ama24/sortering-pnp/docs/images/eartip.png

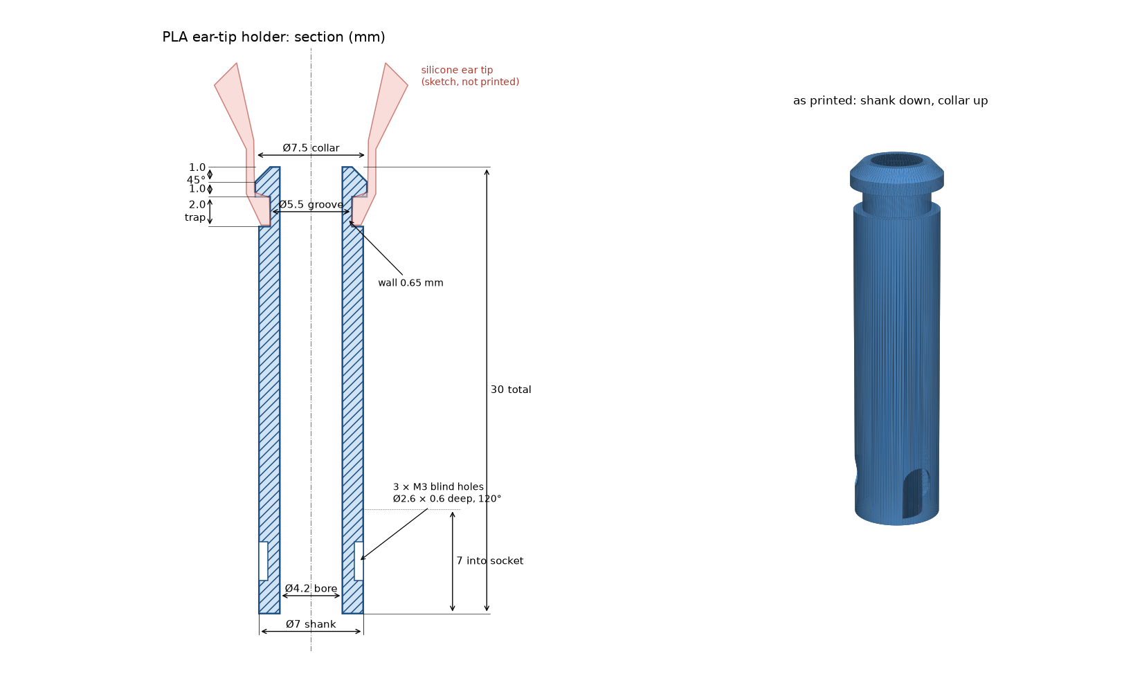
docs/images/eartip.png
