ama24/sortering-pnp/prints/cups/tip_eartip_pla.stl

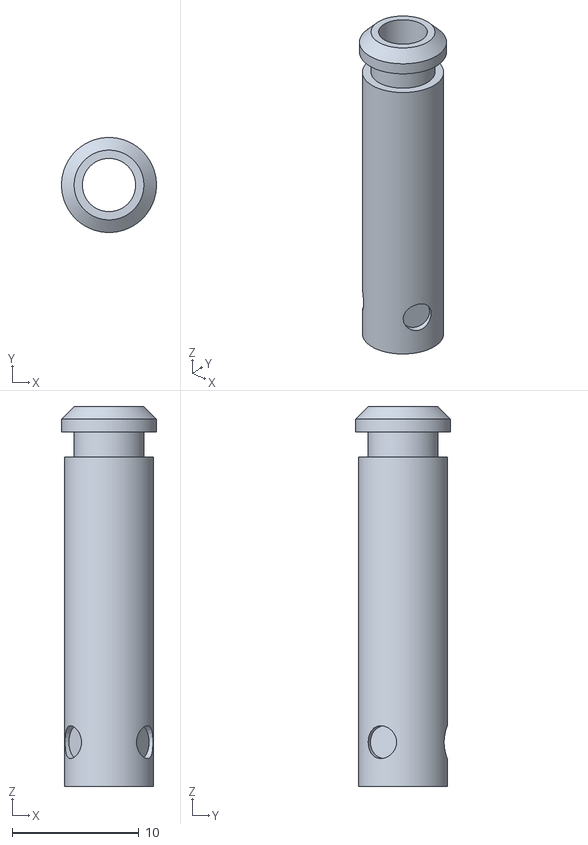
[picture p15: CAD file, 2026-11-09]
prints/cups/tip_eartip_pla.stl
7.50 x 7.50 x 30.0
