ama24/sortering-pnp/prints/mounts/camera_arm_ring.stl

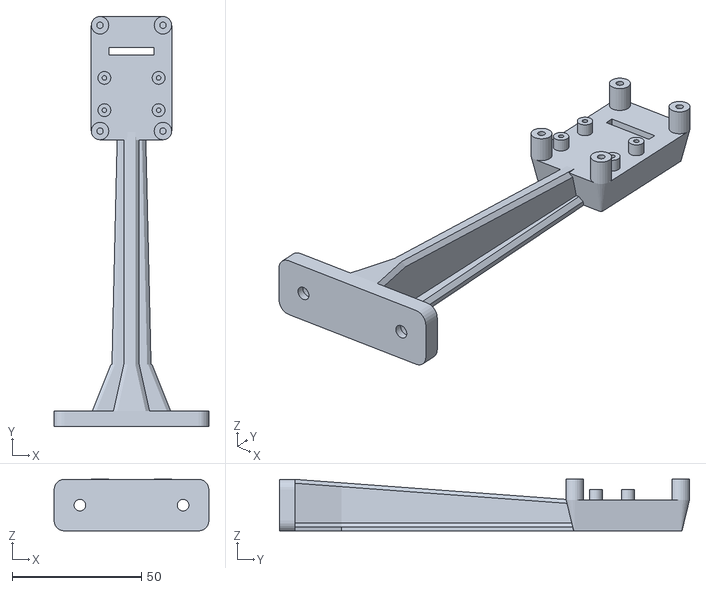
[picture p16: CAD file, 2026-11-07]
prints/mounts/camera_arm_ring.stl
60.0 x 158.9 x 20.1
