ama24/sortering-pnp/prints/tool/tool_holder.stl

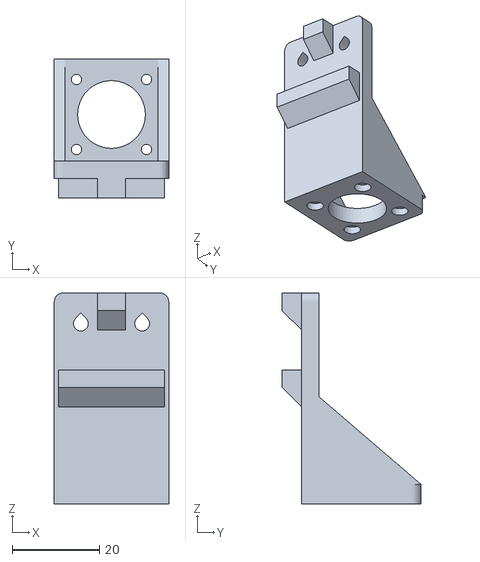
[picture p17: CAD file, 2026-11-08]
prints/tool/tool_holder.stl
26.2 x 31.8 x 48.2
