ama24/sortering-pnp/prints/cups/cup_AS.stl

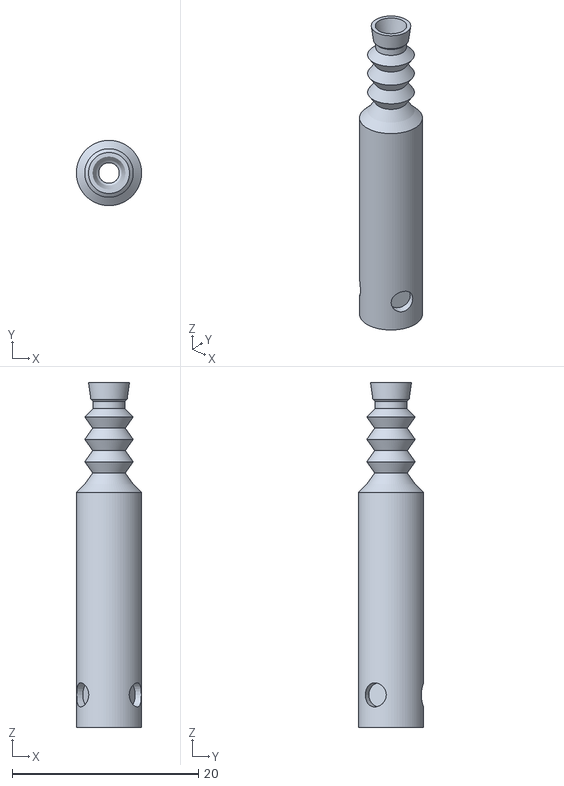
[picture p18: CAD file, 2026-11-08]
prints/cups/cup_AS.stl
7.00 x 7.00 x 37.0
