ama24/sortering-pnp/prints/mounts/ring_bracket.stl

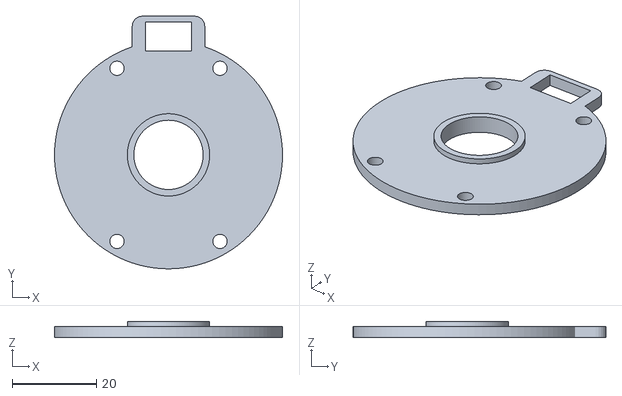
[picture p19: CAD file, 2026-11-07]
prints/mounts/ring_bracket.stl
54.0 x 59.8 x 3.80
