ama24/sortering-pnp/prints/cups/cup_AM_sieve.stl

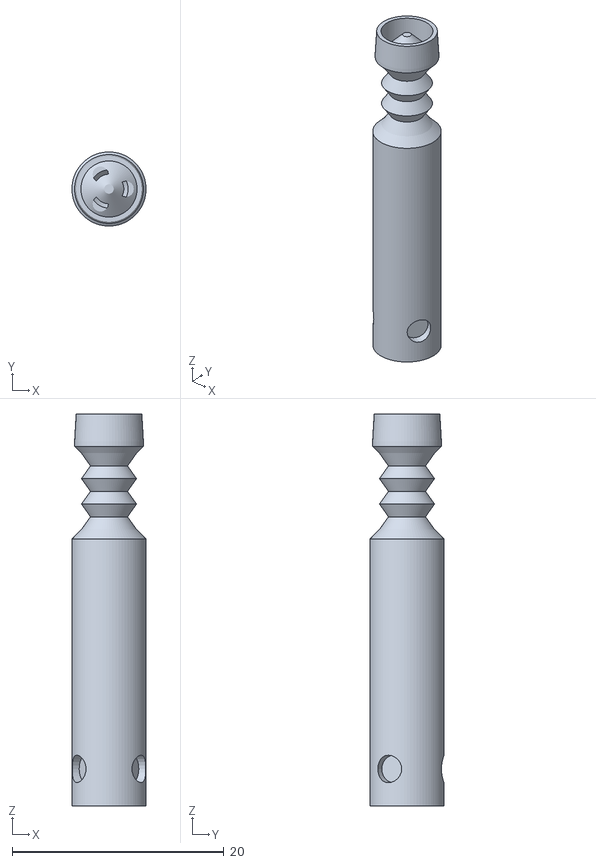
[picture p20: CAD file, 2026-11-08]
prints/cups/cup_AM_sieve.stl
7.00 x 7.00 x 37.0
