ama24/sortering-pnp/prints/mounts/camera_arm.stl

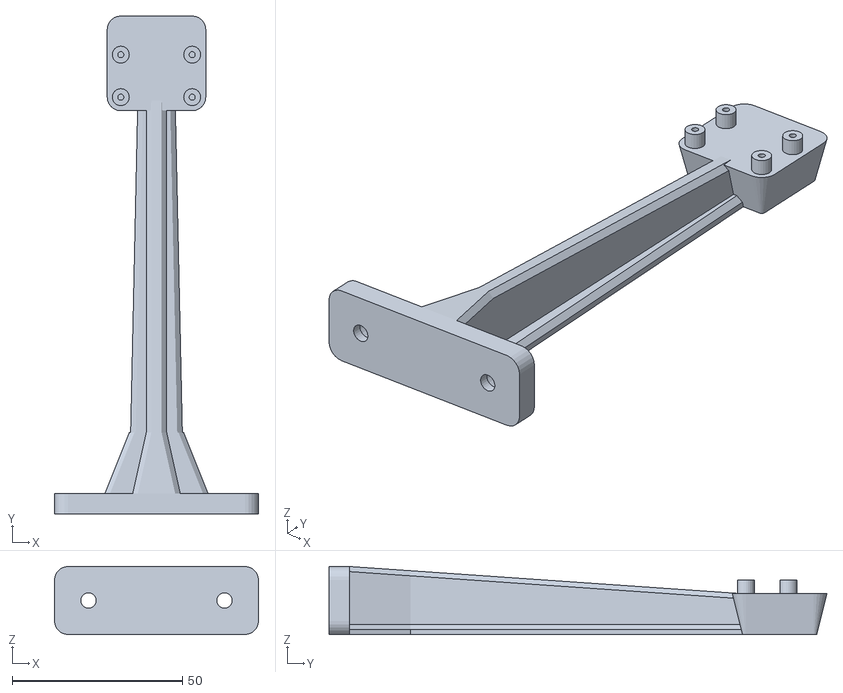
[picture p21: CAD file, 2026-11-07]
prints/mounts/camera_arm.stl
60.0 x 146.5 x 20.0
