ama24/sortering-pnp/prints/mounts/ring_diffuser.stl

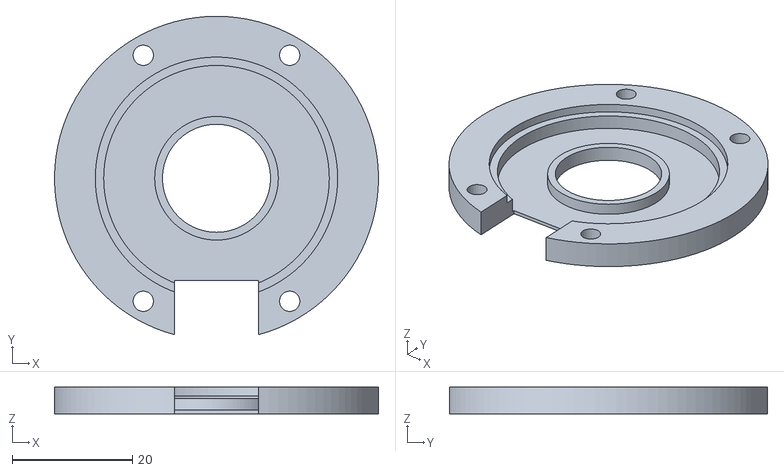
[picture p23: CAD file, 2026-11-07]
prints/mounts/ring_diffuser.stl
54.0 x 53.1 x 4.45
