ama24/sortering-pnp/prints/cups/cup_DM.stl

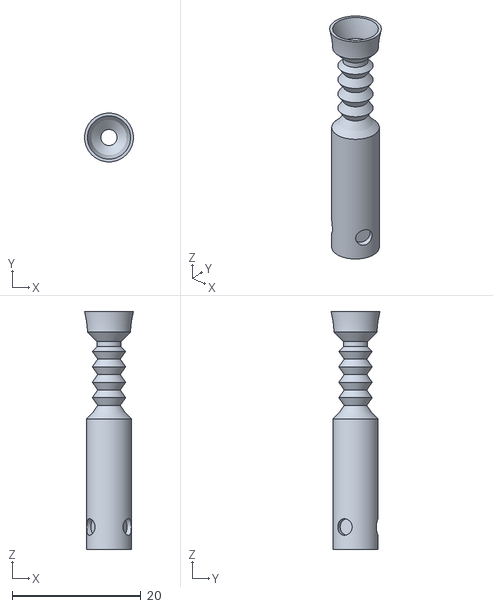
[picture p24: CAD file, 2026-11-08]
prints/cups/cup_DM.stl
7.60 x 7.60 x 37.0
