ama24/sortering-pnp/prints/mounts/ring_clamp.stl

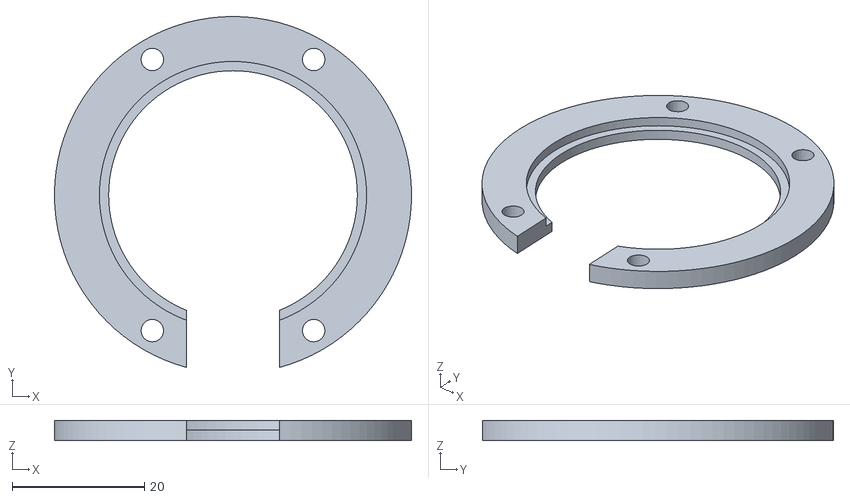
[picture p25: CAD file, 2026-11-07]
prints/mounts/ring_clamp.stl
54.0 x 53.1 x 3.05
