ama24/sortering-pnp/prints/cups/cup_DL_wide.stl

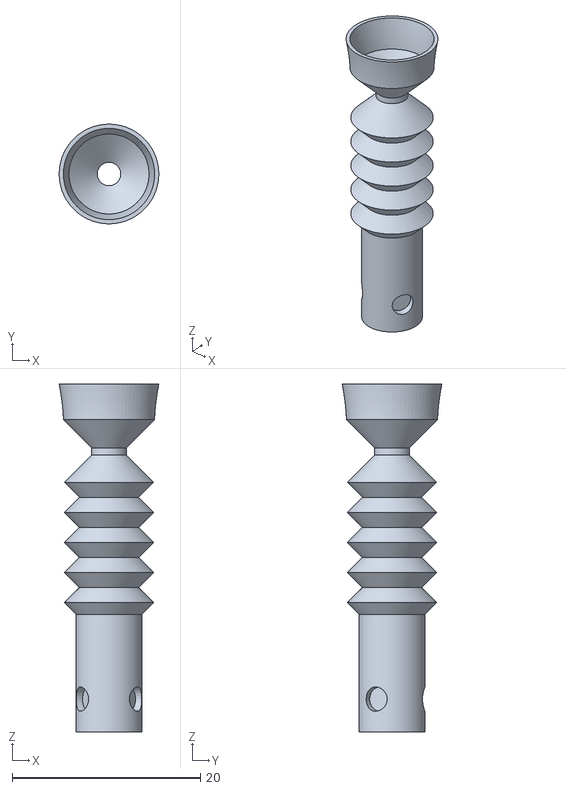
[picture p26: CAD file, 2026-11-08]
prints/cups/cup_DL_wide.stl
10.6 x 10.6 x 37.0
