ama24/sortering-pnp/prints/cups/cup_AM_sieve_wide.stl

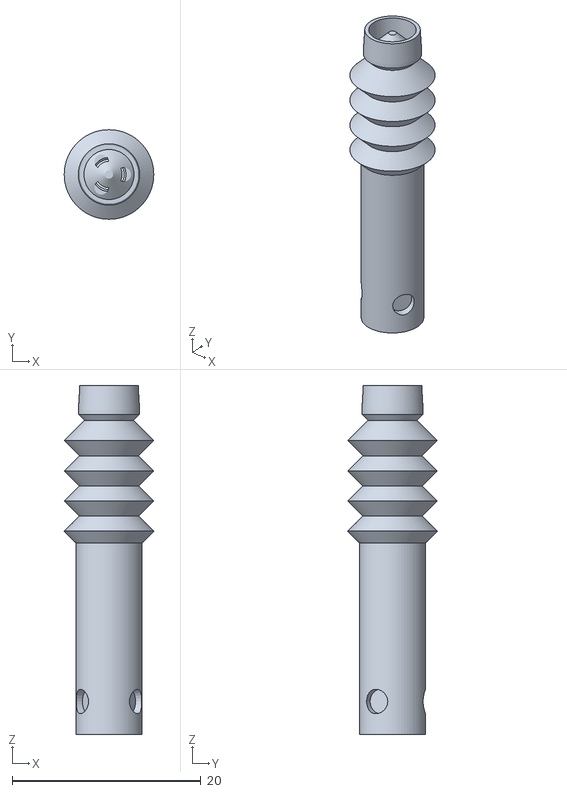
[picture p28: CAD file, 2026-11-08]
prints/cups/cup_AM_sieve_wide.stl
9.50 x 9.50 x 37.0
