ama24/sortering-pnp/prints/cups/cup_DM_sieve.stl

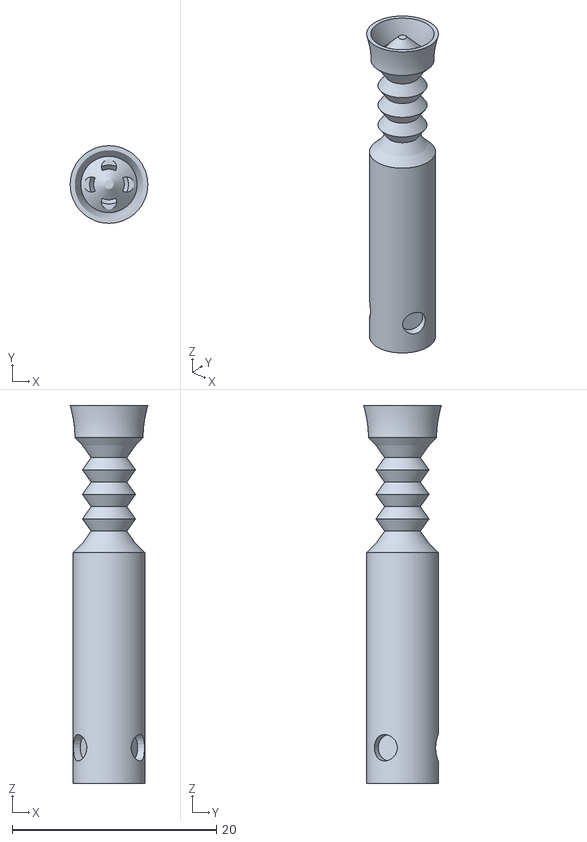
[picture p29: CAD file, 2026-11-08]
prints/cups/cup_DM_sieve.stl
7.60 x 7.60 x 37.0
