ama24/sortering-pnp/prints/cups/cup_AS_wide.stl

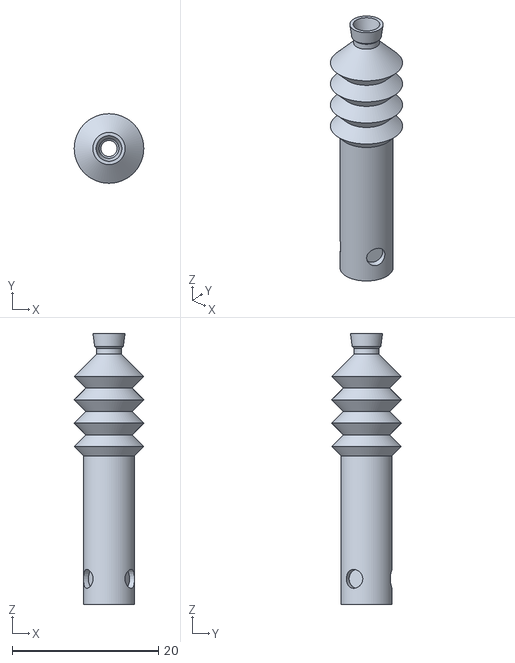
[picture p30: CAD file, 2026-11-08]
prints/cups/cup_AS_wide.stl
9.50 x 9.50 x 37.0
