ama24/sortering-pnp/prints/cups/cup_DL.stl

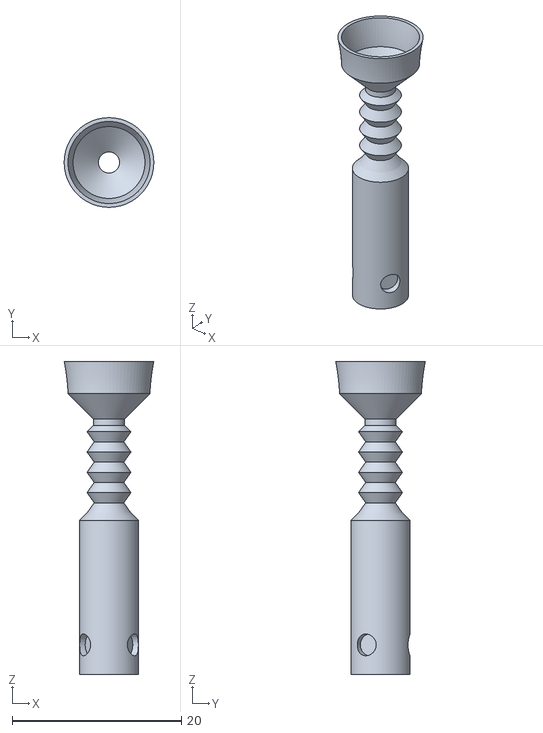
[picture p31: CAD file, 2026-11-08]
prints/cups/cup_DL.stl
10.6 x 10.6 x 37.0
