ama24/sortering-pnp/prints/cups/cup_DM_sieve_wide.stl

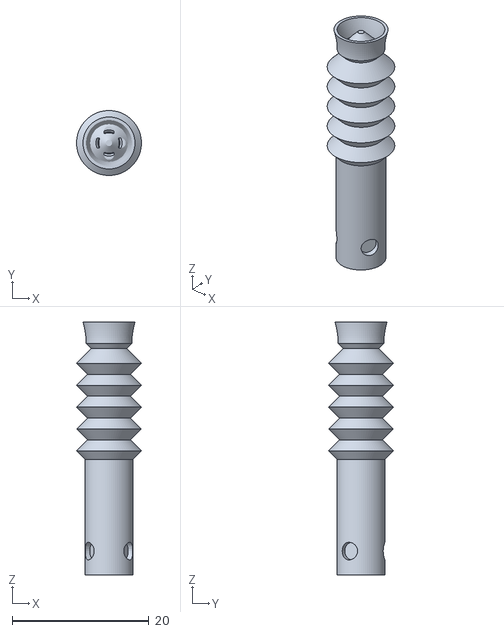
[picture p32: CAD file, 2026-11-08]
prints/cups/cup_DM_sieve_wide.stl
9.50 x 9.50 x 37.0
