ama24/sortering-pnp/(list of files, cad)

Other CAD files:
prints/cups/cup_DS.stl
prints/cups/cup_AM.stl
prints/cups/cup_DS_wide.stl
prints/cups/cup_DM_wide.stl
prints/cups/cup_AM_wide.stl
