ama24/sortering-pnp/src/sortering_pnp/pins.py

"""The picker, switched straight from the Raspberry Pi's pins by sortering-pnp (not by Klipper).

sortering-pnp runs on the Pi next to Klipper, so it needs no second Klipper board for the
picker. The action pin (GPIO12, header pin 32) switches a pump through a MOSFET module (on/off)
or drives the jaw / magnet servo; the turn pin (GPIO13, pin 33) drives the tweezers' turning
servo. Servos get hardware PWM from /sys/class/pwm (the pwm-2chan overlay, which install-pi.sh
adds to config.txt); a pump is a plain output through gpiozero (part of Raspberry Pi OS).

A pump can instead go on the printer board's heated-bed or hotend output (`picker.pump_switch`:
bed / hotend), in place of that heater, which is unplugged from it. Klipper owns those outputs,
so sortering-pnp asks it with G-code: SET_HEATER_TEMPERATURE to `pump_heater_target` (its PID
then switches the output fully on, the thermistor still reading the room) and back to 0.
Klipper's verify_heater stays on: it stops the printer if the output stays on longer than
`check_gain_time` without the heater warming (20 s for the hotend, 60 s for the bed by
default), so a part is never held that long; if the heater is still plugged in, it warms and
the pump is refused above `printer.max_hotend_c`.

Or on the board's part-cooling fan output (`pump_switch: fan`, Klipper's [fan]): M106 S255
switches it on, M107 off. No heater check is involved, so a part may be held as long as needed;
the pump must draw no more than the fan output gives (about 1 A on Creality boards).

Motion waits until Klipper has finished every move (M400) before it calls grab or release.
When the program stops, fails or ends, `off()` switches the pump off; a MOSFET module's
pull-down also keeps it off while nothing drives the pin.
"""

from __future__ import annotations

import logging
import time
from collections.abc import Callable
from pathlib import Path
from typing import Any, Protocol

from .config import Machine
from .printer.base import Printer, PrinterError

log = logging.getLogger("sortering_pnp.pins")

PWM_ROOT = Path("/sys/class/pwm")
SERVO_PERIOD_NS = 20_000_000  # 50 Hz
SERVO_MIN_NS, SERVO_MAX_NS = 500_000, 2_500_000  # 0 and 180 degrees
PWM_CHANNEL = {12: 0, 13: 1, 18: 0, 19: 1}  # GPIO -> PWM channel (pwm-2chan overlay)
TURN_S = 0.35  # a turn of the tweezers takes this long
PERMS_WAIT_S = 3.0  # udev hands a newly exported channel's files to the gpio group within this
HEATERS = {"bed": "heater_bed", "hotend": "extruder"}  # picker.pump_switch -> Klipper heater
HEATER_LAG_S = 0.4  # Klipper sets a heater's output at its next temperature reading (0.3 s)
HEATER_ON_LIMIT_S = {"heater_bed": 60.0, "extruder": 20.0}  # verify_heater's check_gain_time
FAN_LAG_S = 0.1  # M106 / M107 take effect at once (the moves are done: M400)


def _write(path: Path, value: str, sleep: Callable[[float], None] = time.sleep) -> None:
    """Write one sysfs file. Just after an export the channel's files exist but are still
    root's: udev (Raspberry Pi OS's 99-com.rules, and install-pi.sh's own rule) gives them to
    the gpio group a moment later, so a refusal is tried again for a few seconds."""
    step, waited = 0.05, 0.0
    while True:
        try:
            path.write_text(value)
            return
        except PermissionError:
            if waited >= PERMS_WAIT_S:
                raise PrinterError(
                    f"no permission to write {path}: run install-pi.sh again (it puts the user "
                    "in the gpio group and adds the udev rule that gives the gpio group the PWM "
                    "channels), then reboot once"
                ) from None
            sleep(step)
            waited += step


class Pins(Protocol):
    def grab(self) -> None: ...

    def release(self) -> None: ...

    def turn(self, angle_deg: float) -> None:
        """The turning servo to this angle (0..180, offset already added)."""

    def off(self) -> None:
        """Safe state: the pump off. Called on stop, errors and when the program ends."""

    def status(self) -> tuple[bool, str]:
        """Can the pins be used? (ok, what to do if not)"""

    def close(self) -> None: ...


class _Servo:
    """One hardware PWM channel in /sys/class/pwm/pwmchipN, as a hobby servo."""

    def __init__(
        self, chip: Path, channel: int, sleep: Callable[[float], None] = time.sleep
    ) -> None:
        self.dir = chip / f"pwm{channel}"
        self._sleep = sleep
        if not self.dir.is_dir():
            _write(chip / "export", str(channel), sleep)
            for _ in range(50):  # the channel's folder appears a moment later
                if (self.dir / "enable").exists():
                    break
                sleep(0.02)
        # its files are still root's for a moment more: _write waits for udev
        _write(self.dir / "period", str(SERVO_PERIOD_NS), sleep)
        self.enabled = False

    def angle(self, deg: float) -> None:
        a = min(max(float(deg), 0.0), 180.0)
        ns = SERVO_MIN_NS + (SERVO_MAX_NS - SERVO_MIN_NS) * a / 180.0
        _write(self.dir / "duty_cycle", str(int(ns)), self._sleep)
        if not self.enabled:
            _write(self.dir / "enable", "1", self._sleep)
            self.enabled = True


class HeaterPump:
    """A pump on the printer board's bed or hotend output, switched by Klipper (the heater is
    unplugged from that output). on() asks for `target` C; off() for 0, only after an on(): so
    stopping the program never touches a heater someone is printing with."""

    lag_s = HEATER_LAG_S

    def __init__(
        self,
        printer: Printer,
        switch: str,
        target: float,
        limit_c: float,
        clock: Callable[[], float] = time.monotonic,
    ) -> None:
        self.printer = printer
        self.switch = switch
        self.heater = HEATERS[switch]
        self.target = target
        self.limit_c = limit_c
        self._clock = clock
        self._since: float | None = None  # when it was switched on

    @property
    def is_on(self) -> bool:
        return self._since is not None

    def temperature(self) -> float | None:
        st = self.printer.status()
        if not st.ready:
            raise PrinterError(f"Klipper is not ready ({st.state}): it switches the pump")
        return st.bed_c if self.switch == "bed" else st.hotend_c

    def check(self) -> None:
        """Klipper has the heater, and it is cold: nothing but the pump is on its output."""
        t = self.temperature()
        if t is None:
            raise PrinterError(f"Klipper has no {self.heater}: choose another pump switch")
        if t > self.limit_c:
            raise PrinterError(
                f"the {self.switch} reads {t:.0f} C (limit {self.limit_c:.0f} C): unplug its "
                f"heater from the board's {self.switch} output, the pump goes there"
            )

    def on(self) -> None:
        self.check()
        self._send(self.target)
        self._since = self._clock()

    def off(self) -> None:
        if self._since is None:
            return
        held = self._clock() - self._since
        self._since = None
        self._send(0.0)
        limit = HEATER_ON_LIMIT_S[self.heater]
        if held > 0.75 * limit:
            log.warning(
                "the pump ran %.0f s on the %s output: Klipper stops the printer after about "
                "%.0f s",
                held,
                self.switch,
                limit,
            )

    def close(self) -> None:
        self.off()

    def _send(self, target: float) -> None:
        self.printer.gcode(f"SET_HEATER_TEMPERATURE HEATER={self.heater} TARGET={target:g}")


class FanPump:
    """A pump on the printer board's part-cooling fan output (Klipper's [fan]): M106 S255 on,
    M107 off, only after an on(), so stopping the program never stops a print's fan."""

    switch = "fan"
    lag_s = FAN_LAG_S

    def __init__(self, printer: Printer) -> None:
        self.printer = printer
        self._on = False

    @property
    def is_on(self) -> bool:
        return self._on

    def check(self) -> None:
        """Klipper is ready and has a part-cooling fan ([fan])."""
        st = self.printer.status()
        if not st.ready:
            raise PrinterError(f"Klipper is not ready ({st.state}): it switches the pump")
        if st.fan_speed is None:
            raise PrinterError("Klipper has no [fan]: choose another pump switch")

    def on(self) -> None:
        self.check()
        self.printer.gcode("M106 S255")
        self._on = True

    def off(self) -> None:
        if not self._on:
            return
        self._on = False
        self.printer.gcode("M107")

    def close(self) -> None:
        self.off()


def _gpiozero_output(pin: int) -> Any:
    from gpiozero import DigitalOutputDevice  # Raspberry Pi OS: python3-gpiozero

    return DigitalOutputDevice(pin, initial_value=False)


class PiPins:
    """The real pins. Opened on first use, so a PC (or a missing part) fails only there, with
    a message that says what to do."""

    def __init__(
        self,
        m: Machine,
        pwm_root: Path = PWM_ROOT,
        output: Callable[[int], Any] = _gpiozero_output,
        sleep: Callable[[float], None] = time.sleep,
        printer: Printer | None = None,  # switches a pump on the board's bed / hotend output
    ) -> None:
        self.m = m
        self.printer = printer
        self.pwm_root = pwm_root
        self._output = output
        self._sleep = sleep
        self._pump: Any = None
        self._servos: dict[int, _Servo] = {}
        self._mode: tuple[str, str] | None = None  # the picker type and pump switch opened

    # ------------------------------------------------------------------ opening
    def _chip(self) -> Path:
        n = self.m.picker.pwm_chip
        if n is not None:
            chip = self.pwm_root / f"pwmchip{n}"
            if chip.is_dir():
                return chip
            raise PrinterError(f"no {chip}: is picker.pwm_chip right?")
        chips = sorted(self.pwm_root.glob("pwmchip*")) if self.pwm_root.is_dir() else []
        if not chips:
            raise PrinterError(
                "no hardware PWM for the servos: run install-pi.sh (it adds the pwm-2chan line "
                "to config.txt), then reboot once"
            )
        return chips[0]

    def _servo(self, gpio: int) -> _Servo:
        if gpio not in self._servos:
            if gpio not in PWM_CHANNEL:
                raise PrinterError(f"GPIO{gpio} has no hardware PWM: servos go on GPIO12/13")
            self._servos[gpio] = _Servo(self._chip(), PWM_CHANNEL[gpio], self._sleep)
        return self._servos[gpio]

    def _open(self) -> None:
        pk = self.m.picker
        mode = (pk.mode, pk.pump_switch)
        if self._mode == mode:
            return
        self.close()  # another type was chosen: let go of the old pins
        t = pk.kind
        try:
            if t.pump and pk.pump_switch in HEATERS:
                if self.printer is None:
                    raise PrinterError("no printer to switch the pump through")
                self._pump = HeaterPump(
                    self.printer,
                    pk.pump_switch,
                    pk.pump_heater_target,
                    self.m.printer.max_hotend_c,
                )
            elif t.pump and pk.pump_switch == "fan":
                if self.printer is None:
                    raise PrinterError("no printer to switch the pump through")
                self._pump = FanPump(self.printer)
            elif t.pump:
                self._pump = self._output(pk.action_pin)
            else:
                self._servo(pk.action_pin)
            if t.rotates and not pk.rotate_macro:  # a stepper turns through Klipper instead
                self._servo(pk.turn_pin)
        except PrinterError:
            raise
        except ImportError as exc:
            raise PrinterError(
                "gpiozero is missing (sudo apt install python3-gpiozero, or run install-pi.sh)"
            ) from exc
        except Exception as exc:  # noqa: BLE001 - OSError, lgpio's "GPIO busy", gpiozero's own
            raise PrinterError(f"the Pi's pins cannot be used: {exc}") from exc
        self._mode = mode

    def status(self) -> tuple[bool, str]:
        try:
            self._open()
        except PrinterError as exc:
            return False, str(exc)
        pk = self.m.picker
        t = pk.kind
        if isinstance(self._pump, (HeaterPump, FanPump)):
            try:
                if not self._pump.is_on:  # letting go is never refused
                    self._pump.check()
            except PrinterError as exc:
                return False, str(exc)
            used = [f"the board's {pk.pump_switch} output (pump, through Klipper)"]
        else:
            used = [f"GPIO{pk.action_pin} ({'pump' if t.pump else 'servo'})"]
        if t.rotates:
            used.append(
                f"turning: {pk.rotate_macro} in Klipper"
                if pk.rotate_macro
                else f"GPIO{pk.turn_pin} (turning servo)"
            )
        return True, "ready: " + ", ".join(used)

    def _ready(self) -> None:
        ok, why = self.status()
        if not ok:
            raise PrinterError(why)

    # ------------------------------------------------------------------ actions
    def _set(self, holding: bool) -> None:
        self._ready()
        pk = self.m.picker
        t = pk.kind
        if t.pump:
            if holding:
                self._pump.on()
            else:
                self._pump.off()
            if isinstance(self._pump, (HeaterPump, FanPump)):
                self._sleep(self._pump.lag_s)
        else:
            angle = pk.grab_angle if holding else pk.release_angle
            if angle is None:
                angle = t.grab_angle if holding else t.release_angle
            self._servo(pk.action_pin).angle(float(angle or 0.0))
        self._sleep((t.grab_s if holding else t.release_s) + pk.dwell_s)

    def grab(self) -> None:
        self._set(True)

    def release(self) -> None:
        self._set(False)

    def turn(self, angle_deg: float) -> None:
        self._ready()
        self._servo(self.m.picker.turn_pin).angle(angle_deg % 180.0)
        self._sleep(TURN_S)

    def off(self) -> None:
        try:
            if self._pump is not None:
                self._pump.off()
        except Exception:  # noqa: BLE001 - the safe state must never raise
            log.exception("could not switch the pump off")

    def close(self) -> None:
        self.off()
        if self._pump is not None:
            try:
                self._pump.close()
            except Exception:  # noqa: BLE001
                log.exception("could not close the pump pin")
        self._pump = None
        self._servos = {}
        self._mode = None


def make_pins(m: Machine, printer: Printer) -> Pins:
    """The simulator's pins with the simulated printer, the Pi's pins otherwise."""
    from .printer.sim import SimPins, SimPrinter

    if isinstance(printer, SimPrinter):
        return SimPins(printer)
    return PiPins(m, printer=printer)
