ama24/sortering-pnp/src/sortering_pnp/runner.py

"""The sorting loop and everything the web page and the printer menu can ask for.

One cycle: photo position -> photo -> parts and markers -> did the last pick work? -> plan ->
pick and drop (or shake) -> again. Commands (start, pause, resume, stop, step) arrive from the web
page or from the printer's menu and are handled between moves, never in the middle of one: a
part in the picker is always dropped first.
"""

from __future__ import annotations

import copy
import dataclasses
import logging
import math
import threading
import time
from collections import Counter, deque
from collections.abc import Callable, Sequence
from concurrent.futures import Future, ThreadPoolExecutor
from dataclasses import dataclass, field
from pathlib import Path
from typing import Any

import numpy as np

from . import binscheck, binspec, pickers
from . import files as files_mod
from .analysis import ModelChoice
from .binswap import BinRequest, after_ok, choose_swap
from .camera import mirrored, orientation, rotated
from .config import HOME_CORNERS, PUMP_SWITCHES, RUN_MODES, SPEED_RANGE, Machine
from .fill import BinFill, CatalogueVolumes, Packing, bin_room_mm3, part_volume_mm3
from .grip import jaw_angle
from .headcam import merge_markers, merge_parts, shift_part, tiles
from .io import read_json, write_json
from .layout import Layout, yaw_from_up
from .leds import Lights, make_leds, parse_hex
from .models import ModelError, ModelStore
from .parts import Part, compute_gaps, to_bed
from .photos import Photos
from .printer import Motion, Printer, PrinterError
from .rules import family, wild_key
from .rules import match as rule_match
from .setup import KEYS as SETUP_KEYS
from .setup import Setup
from .startup import Checklist, kind_of, parts_in_bin
from .strategies import STRATEGIES, Plan, Planner
from .todo import TodoList
from .transform import MIN_SPREAD_MM, BedCalibration, Transform2D
from .trayview import (
    BinsView,
    WorkArea,
    bin_floor,
    bins_area,
    code_quads_px,
    paint_outside,
    parse_colour,
)
from .trayview import rect as tray_rect
from .vision import Shot, Vision

log = logging.getLogger("sortering_pnp.runner")


@dataclass
class State:
    status: str = "idle"  # idle | running | paused | stopping | done | stuck | error
    message: str = "ready"
    strategy: str = "sort"
    plan: str = ""
    picks: int = 0
    failed_picks: int = 0
    counts: dict[int, int] = field(default_factory=dict)
    shot: str | None = None  # file name of the latest picture with outlines
    timing: dict[str, float] = field(default_factory=dict)  # the last cycle: photo, pick, drop
    parts: list[dict[str, Any]] = field(default_factory=list)
    markers: list[dict[str, Any]] = field(default_factory=list)
    phase: str = ""  # what the machine does right now, in a few words
    target: dict[str, Any] | None = None  # the part it picks next (Device tab: boxed)
    view: str | None = None  # the latest photo without drawings (the page draws on it)
    view_h: list[list[float]] | None = None  # plate mm -> view pixels (3x3 homography)
    # the Device tab's "In the tray": what the last finished analysis found (cls, length,
    # in_work per part), kept while the next photo is taken; None until a model has looked
    census: list[dict[str, Any]] | None = None
    analysing: bool = False  # a new photo is shown, its parts are not known yet


ADJUST_RANGE = {  # Camera Calibration tab: what the sliders may set
    "lens_position": (0.0, 15.0),
    "red_gain": (0.5, 8.0),
    "blue_gain": (0.5, 8.0),
    "exposure_us": (100, 200000),
    "gain": (1.0, 16.0),
    "brightness": (-1.0, 1.0),
    "contrast": (0.0, 2.0),
    "sharpness": (0.0, 4.0),
    "saturation": (0.0, 2.0),
}


class Runner:
    def __init__(
        self, m: Machine, printer: Printer, vision: Vision, store: ModelStore | None = None
    ) -> None:
        self.m = m
        self.printer = printer
        self.motion = Motion(printer, m)
        self.pins = self.motion.pins  # the picker, switched by sortering-pnp itself (pins.py)
        self._leds_driver = make_leds(m, printer)  # the LEDs, on the Pi's SPI (leds.py)
        self.vision = vision
        self.store = store
        self.state = State(strategy=m.run.strategy)
        self.events: deque[str] = deque(maxlen=300)
        self.console: deque[str] = deque(maxlen=200)  # short lines: what it decides
        self._last_seen = ""
        self._lock = threading.RLock()  # the printer: one user at a time (loop or web page)
        self._thread: threading.Thread | None = None
        self._pause = threading.Event()
        self._stop = threading.Event()
        self._now = threading.Event()  # automatic mode: Resume / Start, look and sort now
        self._in_auto = False
        self._mode = ""  # what the sorter thread runs: auto, sort, step or task (Resync, ...)
        self._next_look: float | None = None  # automatic mode: when it looks again (time.time)
        self._shot_t: float | None = None  # when the photo on the page was taken
        self.startup = Checklist()  # the start-up check (startup.py), shown on the Device tab
        self._started_up = False  # done since the program started
        self._shot_no = 0
        self.calib_pairs: list[dict[str, Any]] = []
        cal = self.calibration()
        if cal is not None:
            self.calib_pairs = list(cal.pairs)
        self.last_shot: Shot | None = None
        self._claims_lock = threading.RLock()
        # wild bin marker -> what it collects; bin marker -> parts in it since it was emptied
        self.claims, self.bin_counts, self.bin_volume = self._load_claims()
        self.volumes = self._load_volumes()
        self.ready: dict[int, dict[str, Any]] = {}  # bins that can be taken out
        self.requests: list[BinRequest] = self._loaded_requests  # bin changes, until the OK
        # a bin change takes two OKs (web page or printer menu): the first parks the machine
        # (bed out, hands safe), the second says the bins are changed: a photo checks them
        self._layout_changed = threading.Event()  # the page saved the layout while sorting
        self._park = threading.Event()  # first OK, while sorting: park after this move
        self._ok = threading.Event()  # second OK: the bins are changed
        self.swap_phase = ""  # "" sorting | parked (waiting for the second OK)
        self._no_swap_said = ""
        self.mask_checked = False  # the tray view was checked and saved (Calibrate tab)
        self._crop: dict[str, Any] = {}  # Camera cropping being tried (margin, colour), not saved
        self._binsview: dict[str, Any] = {}  # Bins view being tried (margin, on), not saved
        self._layout_cache: tuple[tuple[str, int, int], Layout] | None = None
        self._tip_touch: tuple[float, float] | None = None  # (offset, surface_z) of the Tip step
        self.markers_seen: set[int] = set()  # every code the camera has read
        self._load_tool()
        self._load_machine()
        self.lights = Lights(m, self._leds_driver)
        self.lights.apply()  # lit from the start when always on
        setup_path = self.m.path(self.m.paths.setup)
        assert setup_path is not None
        self.setup = Setup(setup_path)
        todo_path = self.m.path(self.m.paths.todo)
        assert todo_path is not None
        self.todo = TodoList(todo_path)
        self.photos = Photos(self)  # calibration and real photos (Calibrate and Photos tabs)
        # the simulator needs no setup; a real printer does
        self.require_setup = self.m.printer.driver != "sim"
        self._setup_homed = False  # homed from the Setup tab since the program started
        self._setup_picker: set[str] = set()  # grab / release tried
        self._tool: str | None = None  # the tool Klipper said is mounted, when last asked
        self._calib_markers: list[dict[str, Any]] = []  # the codes in the last calibration photo
        self._calib_fit: dict[str, Any] | None = None  # the last Fit (Camera to printer)

    # ------------------------------------------------------------------ files
    @property
    def layout_path(self) -> Path:
        p = self.m.path(self.m.paths.layout)
        assert p is not None
        return p

    @property
    def transform_path(self) -> Path:
        p = self.m.path(self.m.paths.transform)
        assert p is not None
        return p

    @property
    def runs_dir(self) -> Path:
        p = self.m.path(self.m.paths.runs)
        assert p is not None
        return p

    def layout(self) -> Layout:
        """The layout file, parsed again only when it changed (the page asks for the state
        every second; parsing it each time costs the Pi's CPU and slows every answer). A copy:
        callers may change it."""
        p = self.layout_path
        try:
            st = p.stat()
            key = (str(p), st.st_mtime_ns, st.st_size)
        except FileNotFoundError:
            return Layout.load(p)
        cached = self._layout_cache
        if cached is None or cached[0] != key:
            cached = self._layout_cache = (key, Layout.load(p))
            self._follow_surface(cached[1])
        return copy.deepcopy(cached[1])

    def calibration(self) -> BedCalibration | None:
        return BedCalibration.load(self.transform_path)

    def transform(self) -> Transform2D:
        cal = self.calibration()
        if cal is not None:
            return cal.transform
        if self.m.printer.driver != "sim":
            if self.transform_path.is_file():  # saved, but unusable (e.g. one tip position)
                self.setup.reset("camera")
                raise PrinterError(
                    "Camera to printer is not usable (the tip was at the same place for every "
                    "code): do Setup step 6 again"
                )
            raise PrinterError("the camera is not calibrated to the printer yet: Setup step 6")
        return Transform2D.identity()

    # ------------------------------------------------------------------ status
    def note(self, text: str) -> None:
        log.info(text)
        self.events.append(time.strftime("%H:%M:%S ") + text)

    def say(self, text: str) -> None:
        """One short line on the page's console: what the machine sees and decides."""
        self.console.append(time.strftime("%H:%M:%S ") + text)

    def phase(self, text: str) -> None:
        """What the machine does right now (the Device tab's activity), and a console line."""
        self._set(phase=text)
        self.say(text)

    def _say_seen(self, parts: list[Any], layout: Layout) -> None:
        """What lies on the plate, grouped: '7 on the plate: 3 DIN912_M4x16 · 2 DIN934_M4'."""
        from collections import Counter

        on = [p for p in parts if layout.in_work(p.bed_xy, self.m.run.work_margin_mm)]
        kinds = Counter(
            p.cls + (f"x{p.length_mm:g}" if p.length_mm is not None else "") for p in on
        )
        line = (
            f"{len(on)} on the plate: "
            + " · ".join(f"{n} {k}" for k, n in kinds.most_common(6))
            + (" …" if len(kinds) > 6 else "")
            if on
            else "plate empty"
        )
        if line != self._last_seen:
            self.say(line)
            self._last_seen = line

    def _set(self, **kw: Any) -> None:
        for k, v in kw.items():
            setattr(self.state, k, v)

    def snapshot(self) -> dict[str, Any]:
        s = self.state
        return {
            "status": s.status,
            "message": s.message,
            "strategy": s.strategy,
            "plan": s.plan,
            "picks": s.picks,
            "failed_picks": s.failed_picks,
            "counts": {str(k): v for k, v in s.counts.items()},
            "shot": s.shot,
            "parts": s.parts,
            "census": s.census,
            "analysing": s.analysing,
            "markers": s.markers,
            "events": list(self.events)[-60:],
            "console": list(self.console)[-80:],
            "strategies": STRATEGIES,
            "calibrated": self.transform_path.is_file(),
            "calib_pairs": self.calib_pairs,
            "driver": self.m.printer.driver,
            **self.bins_state(),
            "requests": [r.to_dict() for r in self.requests],
            "mask_margin_mm": self.m.camera.mask_margin_mm,
            "swap_phase": self.swap_phase,
            **self.mode(),
            "tip_offset_z": self.m.tool.offset[2],
            "speed": self.speed_state(),
            "timing": self.state.timing,
            "phase": self.state.phase,
            "target": self.state.target,
            "view": self.state.view,
            "view_h": self.state.view_h,
            "next_look_s": (
                round(max(0.0, self._next_look - time.time()), 1)
                if self._next_look is not None
                else None
            ),
            "startup": self.startup.to_dict(),
            "shot_age_s": (
                round(time.time() - self._shot_t, 1) if self._shot_t is not None else None
            ),
            "setup": {
                "required": self.require_setup,
                "complete": not self.setup.missing(),
                "missing": self.setup.missing(),
            },
        }

    def mode(self) -> dict[str, Any]:
        """What really runs now, for the page (never what is only remembered): mode = auto
        (automatic mode, also while it waits), sort (Sort once), step (One pick), task (a
        Resync, check or bin change done for you) or "" (idle). auto_saved: automatic mode
        was on at the last stop and comes back at the next start."""
        alive = self._thread is not None and self._thread.is_alive()
        mode = ("auto" if self._in_auto else self._mode) if alive else ""
        return {"mode": mode, "auto": mode == "auto", "auto_saved": self.saved_mode()[0]}

    # ------------------------------------------------------------------ commands
    def command(self, cmd: str, strategy: str | None = None) -> str:
        cmd = (cmd or "").strip().lower()
        running = self._thread is not None and self._thread.is_alive()
        resuming = running and self.state.status in ("paused", "stuck") and cmd == "start"
        if (
            cmd in ("start", "step", "auto")
            and self.require_setup
            and self.setup.missing()
            and not resuming
        ):
            return "finish the Setup tab first: " + ", ".join(self.setup.missing())
        if cmd in ("start", "step"):
            if running:
                standby = self._in_auto and self.state.status in ("standby", "stuck", "error")
                if cmd == "start" and (self.state.status in ("paused", "stuck") or standby):
                    return self.command("resume")
                return "already running"
            strat = (strategy or self.state.strategy or self.m.run.strategy).lower()
            if strat not in STRATEGIES:
                return f"unknown strategy {strat!r}"
            self._pause.clear()
            self._stop.clear()
            self._set(
                strategy=strat,
                status="running",
                message=f"starting: {strat}",
                picks=0,
                failed_picks=0,
                counts={},
            )
            self._mode = cmd if cmd == "step" else "sort"
            self._thread = threading.Thread(
                target=self._run,
                args=(strat, 1 if cmd == "step" else None),
                name="sorter",
                daemon=True,
            )
            self._thread.start()
            return f"{cmd}: {strat}"
        if cmd == "auto":
            if running:
                return "already running: stop first"
            strat = (strategy or self.state.strategy or self.m.run.strategy).lower()
            if strat not in STRATEGIES:
                return f"unknown strategy {strat!r}"
            self._pause.clear()
            self._stop.clear()
            self._save_mode(True, strat)
            self._set(
                strategy=strat,
                status="standby",
                message="automatic mode",
                picks=0,
                failed_picks=0,
                counts={},
            )
            self._mode = "auto"
            self._thread = threading.Thread(
                target=self._auto, args=(strat,), name="sorter", daemon=True
            )
            self._thread.start()
            return f"automatic: {strat}"
        if cmd == "startup":
            if self.require_setup and self.setup.missing():
                return "finish the Setup tab first: " + ", ".join(self.setup.missing())
            return self._take_over("start-up check", self._startup_now)
        if cmd in ("change", "change_bin"):
            cmd = "ok"
        if cmd == "ok":  # Change bin: the first press parks; the second checks the bins
            if self.swap_phase == "parking":
                if running:
                    return "parking: wait until it stands still"
                self.swap_phase = ""  # stopped before it parked
            if self.swap_phase != "parked":
                if running:  # sorting or standing by: it parks after the move in progress
                    self.swap_phase = "parking"
                    self._park.set()
                    self._now.set()  # standby: at once
                    self._set(message="parking for a bin change")
                    return "parking"
                self.swap_phase = "parked"
                self._park_idle()
                self.note("parked for a bin change")
                return "parked: change the bins, then Done"
            if running:
                self._ok.set()
                self._now.set()
                self._set(message="checking the bins")
                return "checking the bins"
            self.swap_phase = ""
            res = self.bins_ok()
            return "; ".join(res["resolved"]) or "the bins were checked: nothing was asked for"
        if cmd == "pause":
            if running:
                self._pause.set()
                self._set(status="paused", message="pausing after this move")
            return "paused"
        if cmd == "resume":
            if running and self._in_auto and not self._pause.is_set():
                self._now.set()  # automatic mode waiting: look and sort now
                self._set(message="looking now: sorting what lies on the plate")
                return "looking now"
            if running:
                self._pause.clear()
                self._set(status="running", message="resumed")
            return "resumed"
        if cmd == "stop":
            self._save_mode(False)
            if running:
                self._stop.set()
                self._pause.clear()
                self._set(status="stopping", message="stopping after this move")
            return "stopping"
        if cmd in ("estop", "emergency_stop"):
            self._stop.set()
            self._pause.clear()
            self._save_mode(False)
            self.pins.off()
            try:
                self.printer.emergency_stop()
            finally:
                self._set(
                    status="error", message="EMERGENCY STOP: restart Klipper (FIRMWARE_RESTART)"
                )
                self.note("emergency stop")
            return "emergency stop sent"
        return f"unknown command {cmd!r}"

    def wait(self, timeout: float | None = None) -> None:
        """Until the sorter thread ends (a take-over's thread too)."""
        end = None if timeout is None else time.monotonic() + timeout
        while self._thread is not None:
            t = self._thread
            t.join(None if end is None else max(0.0, end - time.monotonic()))
            if t is self._thread or (end is not None and time.monotonic() >= end):
                return

    def _take_over(self, label: str, fn: Callable[[], str | None]) -> str:
        """Run `fn` now in the sorter thread: whatever runs (a run, automatic mode, a check)
        stops first, after the move in progress (a part in the picker is dropped first, the
        picker is off). Automatic mode carries on afterwards if it was on."""
        old = self._thread if self._thread is not None and self._thread.is_alive() else None
        resume = old is not None and (self._in_auto or self.saved_mode()[0])
        strategy = self.state.strategy
        if old is not None:
            self._stop.set()
            self._pause.clear()
            self._set(status="stopping", message=f"{label}: stopping the current move")
        else:
            self._set(status="running", message=label)

        def run() -> None:
            if old is not None:
                old.join()
            if self.swap_phase == "parking":  # stopped before it parked
                self.swap_phase = ""
            self._stop.clear()
            self._pause.clear()
            self._set(status="running", message=label)
            try:
                done = fn()
            except Exception as exc:  # noqa: BLE001 - shown on the page
                self.pins.off()
                log.exception(label)
                self.note(f"{label} failed: {exc}")
                self._set(status="error", message=f"{label} failed: {exc}")
                return
            if resume and not self._stop.is_set():
                self._auto(strategy)
            else:
                self._set(status="idle", message=done or f"{label}: done")

        self._mode = "task"
        self._thread = threading.Thread(target=run, name="sorter", daemon=True)
        self._thread.start()
        return f"{label}: stopping the current move first" if old is not None else label

    def _park_idle(self) -> None:
        """Change bin while idle: the bed out to the photo position, if it can move."""
        try:
            with self._lock:
                self.motion.preflight(home=False)
                self.motion.photo_position()
                self.motion.message("Swap bins, Change bin")
        except Exception as exc:  # noqa: BLE001 - not homed or no printer: the bins can still be changed
            log.info("not parked for the bin change: %s", exc)

    # ------------------------------------------------------------------ one photo
    def _photo_name(self) -> str:
        self._shot_no += 1
        return time.strftime("%Y%m%d-%H%M%S") + f"_{self._shot_no:04d}"

    def take_shot(
        self,
        layout: Layout,
        T: Transform2D | None,
        move: bool = True,
        area: str = "work",
        paint: bool | str = True,
    ) -> Shot:
        """Photo position, photo, parts (with printer X/Y when T is known), markers. `move`
        False: photograph where the bed is (standby with the motors off: still parked).
        A head camera photographs `area`: work (the tray), bins (the grid and around it) or
        here (one photo at the photo position: calibration). `paint`: True, the model sees only
        the tray's inside; "bins", only the floors of the bins whose codes are in the photo
        (camera.bins_mask, trayview.py); False, the whole photo."""
        work: WorkArea | BinsView | None
        if paint == "bins":
            c = self.m.camera
            work = BinsView(c.bins_margin_mm) if c.bins_mask and c.source != "head" else None
        else:
            work = self._work_area(layout, T) if paint else None
        if self.m.camera.source == "head":
            return self._head_shot(layout, T, area, work if isinstance(work, WorkArea) else None)
        with self._lock:
            if move:
                self.phase("parking at the photo position")
                self.motion.photo_position()
            name = self._photo_name()
            heights = lambda mid: _marker_plate_height(layout, mid)  # noqa: E731
            if hasattr(self.vision, "snap") and hasattr(self.vision, "analyse"):
                self.phase("taking a photo")
                with self.lights.for_photo():
                    photo = self.vision.snap(name)
                self._show_photo(photo, name)
                self.phase("running the model")
                try:
                    shot = (
                        self.vision.analyse(photo, name, heights, work)
                        if work is not None
                        else self.vision.analyse(photo, name, heights)
                    )
                finally:
                    self._set(analysing=False)
            else:
                self.phase("taking a photo")
                with self.lights.for_photo():
                    shot = (
                        self.vision.capture(name, heights, work)
                        if work is not None
                        else self.vision.capture(name, heights)
                    )
        return self._finish_shot(shot, layout, T)

    def _work_area(self, layout: Layout, T: Transform2D | None) -> WorkArea | None:
        """The tray's inside (and its corner post) in the plate frame, for painting the rest."""
        if T is None or not self.m.camera.mask:
            return None
        Ti = T.inverse()
        g = self.m.camera.mask_margin_mm  # + keeps more of the wall, - paints more of the floor
        x0, y0, x1, y1 = layout.work_rect()
        post = layout.work_keepout()
        holes = []
        if post is not None:
            px0, py0, px1, py1 = post
            holes = [Ti.apply(tray_rect(px0 + g, py0 + g, px1 - g, py1 - g))]
        return WorkArea(Ti.apply(tray_rect(x0 - g, y0 - g, x1 + g, y1 + g)), holes)

    # ------------------------------------------------------------------ what the model sees
    def mask_preview(self, margin_mm: float) -> dict[str, Any]:
        """A photo painted with this margin (not saved): the Device tab's photo shows what the
        model sees."""
        self._idle()
        layout, T = self.layout(), self.transform()
        with self._lock:
            self.motion.preflight(home=False)
        old = self.m.camera.mask_margin_mm
        self.m.camera.mask_margin_mm = float(margin_mm)
        try:
            shot = self.take_shot(layout, T)
        finally:
            self.m.camera.mask_margin_mm = old
        return {
            "image": shot.vis.name if shot.vis else None,
            "parts": len(shot.parts),
            "margin_mm": float(margin_mm),
        }

    def remember_machine(self, values: dict[str, Any]) -> None:
        """Keep values set in the page in machine.json (over machine.yaml)."""
        p = self.m.path(self.m.paths.machine)
        assert p is not None
        kept = read_json(p) if p.is_file() else {}
        write_json(p, {**kept, **values})

    def camera_height(self, height_mm: float) -> dict[str, Any]:
        """Skip the camera calibration for now (Calibrate tab): the camera is taken as straight
        down over the picture's centre, this high above the tray floor. A calibration made
        later replaces it."""
        self._idle()
        h = float(height_mm)
        if not 100.0 <= h <= 1000.0:
            raise ValueError("the camera's height: lens to the tray floor, 100 to 1000 mm")
        self.m.camera.height_mm = h
        self.remember_machine({"camera_height_mm": h})
        reload = getattr(self.vision, "reload_setup", None)
        if reload is not None:
            reload()
        self.note(f"camera calibration skipped: straight down, {h:g} mm above the tray floor")
        return self.photos.state()

    def camera_flip(self, hflip: bool, vflip: bool, turn90: bool | None = None) -> dict[str, Any]:
        """The picture's orientation (the camera's flips, both = turned 180 degrees, and a
        quarter turn in software), for photos and the live picture. What was fitted to the old
        picture no longer holds: Camera to printer (and a camera calibration) must be done
        again."""
        self._idle()
        c = self.m.camera
        q = c.turn90 if turn90 is None else bool(turn90)
        if (c.hflip, c.vflip, c.turn90) == (bool(hflip), bool(vflip), q):
            return self.photos.state()
        turned = c.turn90 != q
        c.hflip, c.vflip, c.turn90 = bool(hflip), bool(vflip), q
        self.remember_machine(
            {"camera_hflip": c.hflip, "camera_vflip": c.vflip, "camera_turn90": c.turn90}
        )
        reopen = getattr(self.vision, "reopen_camera", None)
        if reopen is not None:
            reopen()
        reload = getattr(self.vision, "reload_setup", None)
        if reload is not None and turned:  # the nominal camera's picture: taller, or wide again
            reload()
        self.calib_clear()
        self.setup.reset("camera")
        self.last_shot = None
        o = orientation(c.hflip, c.vflip, c.turn90)
        self.note(
            f"camera picture turned {o['turn']}°{', mirrored' if o['mirror'] else ''}: "
            "do Camera to printer again"
        )
        return self.photos.state()

    def camera_orient(self, action: str) -> dict[str, Any]:
        """Rotate 90° (clockwise) or Mirror (left-right), from the Camera Calibration tab."""
        c = self.m.camera
        step = {"rotate": rotated, "mirror": mirrored}.get(action)
        if step is None:
            raise ValueError("rotate or mirror")
        return self.camera_flip(*step(c.hflip, c.vflip, c.turn90))

    def camera_adjust(self, values: dict[str, Any]) -> dict[str, Any]:
        """Focus, white balance, exposure and image adjustments from the page: kept, and
        applied to the camera at once (photos and the live picture)."""
        a = self.m.camera.adjust
        new = {k: v for k, v in (values or {}).items() if hasattr(a, k)}
        if values and not new:
            raise ValueError("nothing to adjust")
        for k, v in new.items():
            old = getattr(a, k)
            if isinstance(old, str):
                if v not in ("auto", "manual"):
                    raise ValueError(f"{k}: auto or manual")
                setattr(a, k, v)
            else:
                lo, hi = ADJUST_RANGE[k]
                setattr(a, k, type(old)(min(hi, max(lo, float(v)))))
        self.remember_machine({"camera_adjust": dataclasses.asdict(a)})
        apply = getattr(self.vision, "adjust_camera", None)
        now = apply() if apply is not None else {}
        return {"adjust": dataclasses.asdict(a), "now": now}

    def camera_focus(self) -> dict[str, Any]:
        """Autofocus once on the tray, then keep that lens position (focus: manual)."""
        focus = getattr(self.vision, "focus_once", None)
        pos = focus() if focus is not None else None
        if pos is None:
            raise ValueError("no autofocus on this camera")
        out = self.camera_adjust({"focus": "manual", "lens_position": pos})
        self.note(f"camera focused: lens position {pos:.2f} (about {1000 / max(pos, 0.01):.0f} mm)")
        return out

    def camera_state(self) -> dict[str, Any]:
        c = self.m.camera
        now = getattr(self.vision, "camera_now", lambda: {})()
        return {
            "adjust": dataclasses.asdict(c.adjust),
            "now": now,
            "orientation": orientation(c.hflip, c.vflip, c.turn90),
            "locked": bool(c.settings),
        }

    def calibration_settings(
        self, measured_square_mm: float | None, board_thickness_mm: float
    ) -> dict[str, Any]:
        c = self.m.calibration
        c.measured_square_mm = float(measured_square_mm) if measured_square_mm else None
        c.board_thickness_mm = float(board_thickness_mm)
        self.remember_machine(
            {
                "calibration": {
                    "measured_square_mm": c.measured_square_mm,
                    "board_thickness_mm": c.board_thickness_mm,
                }
            }
        )
        return self.photos.state()

    def calibration_replaced(self) -> None:
        """A new camera calibration: its plate frame starts at the board, so the old camera-to-
        printer fit is wrong now. It is kept aside, and the Setup step asks for it again."""
        if self.transform_path.is_file():
            aside = self.transform_path.with_name(
                self.transform_path.stem + time.strftime("_before_%Y%m%d-%H%M%S.json")
            )
            self.transform_path.replace(aside)
        self.calib_pairs = []
        self.setup.reset("camera")
        self.note("new camera calibration: redo Camera to printer (Setup tab, step 6)")

    def mask_save(self, margin_mm: float) -> dict[str, Any]:
        self.remember_machine({"mask_margin_mm": float(margin_mm)})
        self.m.camera.mask_margin_mm = float(margin_mm)
        self.mask_checked = True
        self.note(f"tray view saved: margin {float(margin_mm):g} mm")
        return {"margin_mm": float(margin_mm), "saved": True}

    # ------------------------------------------------------------------ camera cropping
    def crop_state(self) -> dict[str, Any]:
        """Camera cropping (Calibrate tab): only for the model that finds the parts. It needs the
        camera-to-printer fit and the bins (where the tray is); the camera calibration, or the
        straight-down camera at its height until then."""
        missing = []
        if self.calibration() is None and self.m.printer.driver != "sim":
            missing.append("Camera to printer (Setup tab, step 6)")
        if not self.setup.is_done("layout") and self.m.printer.driver != "sim":
            missing.append("the bins found (Setup tab, step 7)")
        c = self.m.camera
        return {
            "ready": not missing,
            "missing": missing,
            "margin_mm": float(self._crop.get("margin", c.mask_margin_mm)),
            "colour": str(self._crop.get("colour", c.mask_colour)),
            "saved_margin_mm": c.mask_margin_mm,
            "saved_colour": c.mask_colour,
            "changed": bool(self._crop),
        }

    def crop_preview(self, margin_mm: float, colour: str) -> dict[str, Any]:
        """Try a margin and a colour on the live picture (not saved)."""
        parse_colour(colour)  # auto or #RRGGBB, else ValueError
        self._crop = {"margin": float(margin_mm), "colour": colour}
        return self.crop_state()

    def crop_save(self, margin_mm: float, colour: str) -> dict[str, Any]:
        parse_colour(colour)
        self.mask_save(margin_mm)
        self.remember_machine({"mask_colour": colour})
        self.m.camera.mask_colour = colour
        self._crop = {}
        return self.crop_state()

    def crop_frame(self, frame: np.ndarray) -> np.ndarray:
        """A live frame painted and cut as the model will see it: the tray's inside only (the
        working area of the layout, through the camera-to-printer fit), with the margin and
        colour being tried."""
        from .photos import placeholder

        st = self.crop_state()
        cam = getattr(self.vision, "cam_full", None)
        calib = getattr(self.vision, "calibration", None)
        if not st["ready"] or cam is None:
            return placeholder("Camera cropping needs: " + ", ".join(st["missing"] or ["a camera"]))
        c = self.m.camera
        old = (c.mask, c.mask_margin_mm)
        c.mask, c.mask_margin_mm = True, st["margin_mm"]
        try:
            work = self._work_area(self.layout(), self.transform())
        finally:
            c.mask, c.mask_margin_mm = old
        if work is None:
            return placeholder("no working area: Setup tab, step 7 (Find bins)")
        s = frame.shape[1] / float(cam.image_size[0])

        def px(poly: np.ndarray) -> np.ndarray:
            return cam.project(np.c_[poly, np.zeros(len(poly))]) * s

        img = paint_outside(
            frame, px(work.outline), [px(h) for h in work.holes], parse_colour(st["colour"])
        )
        roi = (calib or {}).get("roi")
        if roi:  # the model gets this part of the photo (its size unchanged)
            x0, y0 = int(roi["x0"] * s), int(roi["y0"] * s)
            img = img[y0 : y0 + int(roi["h"] * s), x0 : x0 + int(roi["w"] * s)]
        return img

    # ------------------------------------------------------------------ speed and mode
    def speed_state(self) -> dict[str, Any]:
        """The Device tab's Speed and Mode buttons: what is set now (used from the next move,
        and for the mode from the next photo)."""
        r = self.m.run
        return {
            "pct": r.speed_pct,
            "range": list(SPEED_RANGE),
            "mode": r.mode,
            "turbo_picks": r.turbo_picks,
        }

    def set_speed(self, pct: float) -> dict[str, Any]:
        """Speed of every move, 50..300 % (feed rates and accelerations; Klipper's limits still
        apply). Used from the next move, also while sorting; kept in machine.json."""
        pct = float(pct)
        lo, hi = SPEED_RANGE
        if not lo <= pct <= hi:
            raise ValueError(f"speed: {lo:g} to {hi:g} %")
        self.m.run.speed_pct = round(pct)
        self.remember_machine({"speed_pct": self.m.run.speed_pct})
        self.note(f"speed {self.m.run.speed_pct:g} %")
        return self.speed_state()

    def set_mode(self, mode: str, turbo_picks: int | None = None) -> dict[str, Any]:
        """Single (a photo before every pick) or turbo (`turbo_picks` picks per photo, the photo
        analysed while it goes on picking). Used from the next photo, also while sorting."""
        if mode not in RUN_MODES:
            raise ValueError(f"mode: one of {', '.join(RUN_MODES)}")
        r = self.m.run
        if turbo_picks is not None:
            n = int(turbo_picks)
            if not 1 <= n <= 100:
                raise ValueError("turbo: 1 to 100 picks per photo")
            r.turbo_picks = n
        r.mode = mode
        self.remember_machine({"run_mode": r.mode, "turbo_picks": r.turbo_picks})
        self.note("mode: single" if mode == "single" else f"mode: turbo, {r.turbo_picks} per photo")
        return self.speed_state()

    # ------------------------------------------------------------------ bins view
    def binsview_state(self) -> dict[str, Any]:
        """Bins view (Calibrate tab): what the model sees when it looks into the bins: the
        floors of the bins whose codes are in the picture (trayview.py). Needs the camera
        calibration (or the straight-down camera) and the codes in view; nothing else."""
        c = self.m.camera
        return {
            "enabled": bool(self._binsview.get("enabled", c.bins_mask)),
            "margin_mm": float(self._binsview.get("margin", c.bins_margin_mm)),
            "saved_enabled": c.bins_mask,
            "saved_margin_mm": c.bins_margin_mm,
            "changed": bool(self._binsview),
            "head": c.source == "head",  # the head camera looks at the bins unpainted
        }

    def binsview_preview(self, margin_mm: float, enabled: bool | None = None) -> dict[str, Any]:
        """Try a margin on the live picture (not saved)."""
        self._binsview["margin"] = float(margin_mm)
        if enabled is not None:
            self._binsview["enabled"] = bool(enabled)
        return self.binsview_state()

    def binsview_save(self, margin_mm: float, enabled: bool) -> dict[str, Any]:
        c = self.m.camera
        c.bins_margin_mm, c.bins_mask = float(margin_mm), bool(enabled)
        self.remember_machine({"bins_margin_mm": c.bins_margin_mm, "bins_mask": c.bins_mask})
        self._binsview = {}
        self.note(
            f"bins view saved: margin {c.bins_margin_mm:g} mm"
            if c.bins_mask
            else "bins view off: the model looks at the whole photo"
        )
        return self.binsview_state()

    def _bins_painted(
        self, frame: np.ndarray
    ) -> tuple[np.ndarray, list[tuple[int, np.ndarray]]] | str:
        """A live frame painted as the bins view (the margin being tried), cut to the
        calibration's ROI, and each bin's floor in its pixels; or why it cannot be."""
        from .markers import detect, marker_pose

        st = self.binsview_state()
        cam = getattr(self.vision, "cam_full", None)
        if cam is None:
            return "Bins view needs the camera"
        if not st["enabled"]:
            return "Bins view is off: the model looks at the whole photo"
        s = frame.shape[1] / float(cam.image_size[0])
        layout = self.layout()
        found = detect(frame)
        poses = [
            marker_pose(
                m,
                lambda px, mid=m.marker: cam.pixel_to_plate(
                    px / s, _marker_plate_height(layout, mid)
                ),
            )
            for m in found
        ]
        area = bins_area(poses, st["margin_mm"])
        if area is None:
            return "no bin codes in the picture"

        def px(poly: np.ndarray) -> np.ndarray:
            return cam.project(np.c_[poly, np.zeros(len(poly))]) * s

        img = paint_outside(
            frame,
            [px(o) for o in area.outlines],
            [px(h) for h in area.holes] + code_quads_px(m.corners_px for m in found),
            parse_colour(self.m.camera.mask_colour),
        )
        floors = []
        for m in poses:
            got = bin_floor(m.marker, m.centre, m.up_deg, st["margin_mm"])
            if got is not None:
                floors.append((m.marker, px(got[0])))
        calib = getattr(self.vision, "calibration", None)
        roi = (calib or {}).get("roi")
        if roi:  # the model gets this part of the photo (its size unchanged)
            x0, y0 = int(roi["x0"] * s), int(roi["y0"] * s)
            img = img[y0 : y0 + int(roi["h"] * s), x0 : x0 + int(roi["w"] * s)]
            floors = [(mk, f - (x0, y0)) for mk, f in floors]
        return img, floors

    def bins_frame(self, frame: np.ndarray) -> np.ndarray:
        """The live picture as the model sees the bins (Calibrate tab: Bins view)."""
        from .photos import placeholder

        got = self._bins_painted(frame)
        return placeholder(got) if isinstance(got, str) else got[0]

    def bins_snippets(self) -> bytes:
        """One JPEG: each bin's floor cut out of the bins view, side by side at the photo's own
        scale, with its code and size: does the model see every bin, and all of its floor?"""
        import cv2

        from .binspec import size_for_marker
        from .photos import placeholder

        frame = getattr(self.vision, "frame", lambda: None)()
        got = "no camera picture yet" if frame is None else self._bins_painted(np.asarray(frame))
        if isinstance(got, str):
            img = placeholder(got, (960, 200))
        else:
            view, floors = got
            tiles = []
            for mk, f in sorted(floors, key=lambda t: t[0]):
                x0, y0 = np.floor(f.min(axis=0)).astype(int)
                x1, y1 = np.ceil(f.max(axis=0)).astype(int)
                x0, y0 = max(x0 - 4, 0), max(y0 - 4, 0)
                x1, y1 = min(x1 + 4, view.shape[1]), min(y1 + 4, view.shape[0])
                if x1 - x0 < 8 or y1 - y0 < 8:
                    continue
                cut = view[y0:y1, x0:x1]
                size = size_for_marker(mk)
                head = np.full((26, max(cut.shape[1], 150), 3), 40, np.uint8)
                text = f"{mk}  {size.name if size else '?'}"
                cv2.putText(head, text, (6, 18), cv2.FONT_HERSHEY_SIMPLEX, 0.55, (255,) * 3, 1)
                body = np.full((cut.shape[0], head.shape[1], 3), 255, np.uint8)
                body[:, : cut.shape[1]] = cut
                tiles.append(np.vstack([head, body]))
            img = _tile(tiles) if tiles else placeholder("no bin floors in view", (960, 200))
        ok, buf = cv2.imencode(".jpg", img, [cv2.IMWRITE_JPEG_QUALITY, 85])
        if not ok:
            raise OSError("could not encode the bins snippets")
        return buf.tobytes()

    # ------------------------------------------------------------------ on the machine
    def todo_state(self) -> dict[str, Any]:
        return {"items": self.todo.state(self)}

    def todo_tick(self, key: str, done: bool) -> dict[str, Any]:
        self.todo.tick(key, done)
        return self.todo_state()

    def _head_shot(
        self, layout: Layout, T: Transform2D | None, area: str, work: WorkArea | None = None
    ) -> Shot:
        """The head camera over `area`: overlapping photos, joined in the frame of the
        calibration photo (headcam.py)."""
        hc = self.m.camera.head
        pc = self.m.printer
        ref = np.asarray(pc.photo_position[:2], dtype=float)
        if area == "here" or T is None:
            spots = [tuple(ref)]
        else:
            if area == "bins":
                k = hc.margin_cells
                rect = layout.cells_rect(-k, -k, layout.cols + 2 * k, layout.rows + 2 * k)
            else:
                rect = layout.work_rect()
            ox, oy = hc.offset
            spots = [
                (
                    min(max(x - ox, pc.limits_x[0]), pc.limits_x[1]),
                    min(max(y - oy, pc.limits_y[0]), pc.limits_y[1]),
                )
                for x, y in tiles(rect, hc.fov_mm, hc.overlap)
            ]
        Ai = np.linalg.inv(T.A) if T is not None else np.eye(2)
        name = self._photo_name()
        parts: list[Any] = []
        markers: list[Any] = []
        last: Shot | None = None
        for k, (x, y) in enumerate(spots):
            with self._lock:
                self.motion.travel(x, y)
                self.motion.move(z=pc.photo_position[2])
                self.printer.gcode("M400")
            d = Ai @ (np.array([x, y]) - ref)  # the view moved with the head
            with self._lock, self.lights.for_photo():
                last = self.vision.capture(
                    f"{name}_{k:02d}",
                    lambda mid: _marker_plate_height(layout, mid),
                    work.shifted(-d) if work is not None else None,
                )
            for p in last.parts:
                shift_part(p, d)
            for mk in last.markers:
                mk.centre = (mk.centre[0] + d[0], mk.centre[1] + d[1])
            parts += last.parts
            markers += last.markers
        assert last is not None
        shot = Shot(
            name,
            merge_parts(parts, hc.same_mm),
            merge_markers(markers),
            last.photo,
            last.vis,
        )
        return self._finish_shot(shot, layout, T)

    def _show_photo(self, photo: Any, name: str) -> None:
        """The photo on the page at once, before the model has looked at it (its parts and codes
        follow when it has)."""
        preview = getattr(self.vision, "preview", None)
        if preview is None:
            return
        try:
            shown = preview(photo, name)
        except Exception:  # noqa: BLE001 - only the early picture is missing
            log.exception("preview of %s", name)
            return
        if shown is None:
            return
        view, view_h = shown
        self._shot_t = time.time()
        # the outlines belong to the old photo and go; the census ("In the tray") stays until
        # the analysis of this one replaces it
        self._set(
            view=Path(view).name,
            view_h=view_h,
            shot=None,
            parts=[],
            markers=[],
            target=None,
            analysing=True,
        )

    def _finish_shot(self, shot: Shot, layout: Layout, T: Transform2D | None) -> Shot:
        self.markers_seen |= {mk.marker for mk in shot.markers}
        self._shot_t = time.time()
        if T is not None:
            to_bed(shot.parts, T)
        compute_gaps(shot.parts)
        self.last_shot = shot
        self._prune_photos()
        parts = [
            {
                "id": p.id,
                "cls": p.cls,
                "poly": _poly_for_page(p.polygon),
                "xy": [round(float(v), 1) for v in p.plate_xy],
                "length": p.length_mm,
                "score": round(p.score, 2),
                "bed": [round(v, 1) for v in p.bed_xy] if T is not None else None,
                "gap": None if math.isinf(p.gap_mm) else round(p.gap_mm, 1),
                "in_work": bool(
                    T is not None and layout.in_work(p.bed_xy, self.m.run.work_margin_mm)
                ),
            }
            for p in shot.parts
        ]
        # without a model only the codes were read: no parts is not an empty tray
        modelled = not getattr(self.vision, "model_missing", lambda: None)()
        census = (
            [{k: d[k] for k in ("cls", "length", "in_work")} for d in parts]
            if modelled
            else self.state.census
        )
        self._set(
            shot=shot.vis.name if shot.vis else None,
            view=shot.view.name if getattr(shot, "view", None) else None,
            view_h=getattr(shot, "view_h", None),
            parts=parts,
            census=census,
            analysing=False,
            markers=[
                {
                    "marker": mk.marker,
                    "plate": [round(v, 2) for v in mk.centre],
                    "view_px": [round(float(v), 1) for v in mk.view_px] if mk.view_px else None,
                    "cell": _cell_of(layout, mk.marker),
                }
                for mk in shot.markers
            ],
        )
        return shot

    def _prune_photos(self) -> None:
        keep = self.m.run.keep_photos
        if keep <= 0 or not self.runs_dir.is_dir():
            return
        photos = sorted(self.runs_dir.glob("*_[0-9][0-9][0-9][0-9].jpg"))
        for p in photos[:-keep]:
            for f in (p, *(p.with_name(f"{p.stem}_{s}.jpg") for s in ("vis", "view", "bins"))):
                f.unlink(missing_ok=True)

    # ------------------------------------------------------------------ the loop
    def _run(self, strategy: str, steps: int | None) -> None:
        try:
            outcome = self._sort(strategy, steps)
            if outcome != "done":
                self._set(status="idle", message="stopped" if self._stop.is_set() else "finished")
        except Exception as exc:  # noqa: BLE001 - shown on the web page, the loop must not die silently
            self.pins.off()
            log.exception("sorting stopped")
            self.note(f"error: {exc}")
            self._set(status="error", message=str(exc))

    def _prepare(self) -> tuple[Layout, Transform2D]:
        layout = self.layout()
        T = self.transform()
        x0, y0, x1, y1 = layout.work_rect()
        self.motion.z_home_xy = ((x0 + x1) / 2, (y0 + y1) / 2)  # Z is homed over the plate
        return layout, T

    def _sort(
        self, strategy: str, steps: int | None, auto: bool = False, looked: Shot | None = None
    ) -> str:
        """Sort until the working area is empty: "done", "stuck" (only when `auto`: then the
        caller waits for the parts to change), "stopped" or "steps". `looked`: a photo just
        taken from the photo position, used instead of taking the same one again."""
        missing = getattr(self.vision, "model_missing", lambda: None)()
        if missing:
            raise PrinterError(missing)
        if self.m.run.startup_check and not self._started_up:
            self._start_up()
        layout, T = self._prepare()
        with self._lock:
            self.motion.preflight()
            if self.m.printer.accel:
                self.printer.gcode(f"SET_VELOCITY_LIMIT ACCEL={self.m.printer.accel:.0f}")
            pk = self.m.picker
            if pk.kind.rotates and pk.rotate_macro and pk.rotate_home:  # a stepper finds its 0
                self.printer.gcode(pk.rotate_home)
        ok, why = self.pins.status()
        if not ok:
            raise PrinterError(f"the picker's pins: {why}")
        first: Shot | None = looked
        run = self.m.run
        if run.scan_bins_on_start or run.only_seen_bins:
            if first is None:
                first = self.take_shot(layout, T, area="bins")
            seen = {mk.marker for mk in first.markers}
            if run.scan_bins_on_start:
                moved = self._place_bins(layout, first, T)
                added = [b["marker"] for b in moved if b.get("new")]
                layout.save(self.layout_path)
                if added:
                    self.note(f"new bins seen, used as wild bins: {', '.join(map(str, added))}")
            if run.only_seen_bins:
                # the plate stays even when a part lies on its code: it is never a target
                keep = seen | ({layout.work_marker} if layout.work_marker is not None else set())
                missing = sorted(b.marker for b in layout.bins if b.marker not in keep)
                if missing:
                    self.note(f"bins not seen by the camera, not used: {missing}")
                layout.bins = [b for b in layout.bins if b.marker in keep]
                if not [b for b in layout.bins if b.role != "work"]:
                    raise PrinterError("the camera sees no bins (markers covered or dirty?)")
        problems = layout.problems()
        if problems:
            raise PrinterError("layout: " + "; ".join(problems))
        planner = Planner(layout, self.m, strategy)
        self._park.clear()  # an OK left from before this run
        self._ok.clear()
        self.swap_phase = ""
        wild = {b.marker for b in layout.bins if b.role == "wild"}
        with self._claims_lock:
            for mk in [k for k in self.claims if k not in wild and layout.bin_by_marker(k)]:
                del self.claims[mk]  # no longer a wild bin
            planner.claims = self.claims  # shared: emptied bins apply at once
        self._set(status="running")
        self.note(f"started: {STRATEGIES[strategy]}")
        self.say(f"sorting: {strategy}")
        self._last_seen = ""
        self._z_limit_note()
        c = _RunCtx(layout, T, planner, first, steps, auto)
        loop = "turbo" if self._turbo_now(c) else "single"
        while True:  # single and turbo hand over to each other (Device tab: Mode)
            res = self._turbo_loop(c) if loop == "turbo" else self._single_loop(c)
            if res not in ("single", "turbo"):
                return res
            loop = res  # the loop handed over to

    def _single_loop(self, c: _RunCtx) -> str:
        """A photo before every pick: photo -> pick -> drop -> photo (which shows whether the
        pick worked). "turbo" when the mode is switched to turbo (from the next photo)."""
        layout, T, planner, steps, auto = c.layout, c.T, c.planner, c.steps, c.auto
        first, prev, done_steps = c.first, c.prev, c.done_steps
        c.first, c.prev = None, None
        waiting_for = ""  # the bin change last announced
        cycles = 0
        while not self._stop.is_set():
            if (
                cycles
                and self._turbo_now(c)
                and not (self._pause.is_set() or self._park.is_set() or self._ok.is_set())
            ):
                c.layout, c.first, c.prev, c.done_steps = layout, first, prev, done_steps
                return "turbo"
            cycles += 1
            if self._pause.is_set():
                self._set(
                    status="paused", message="paused: resume from the web page or the printer menu"
                )
                while self._pause.is_set() and not self._stop.is_set():
                    time.sleep(0.2)
                if self._stop.is_set():
                    break
                self._set(status="running")
                planner.shakes_in_row = 0
                prev = None  # someone may have moved parts
                first = None  # ... so a photo from before the pause is out of date
            if self._park.is_set():  # first OK: park and wait for the second
                self._park.clear()
                if self._parked_for_bins():
                    break
                prev = None
                first = None
            if self._ok.is_set():  # after a bin change: a new photo, with the bins
                first = None
            check = self._ok.is_set()  # it must look into the bins: the bins view
            area = "bins" if check else "work"
            # one cycle: photo (parked, picker empty) -> pick -> drop -> back here for the next
            t0 = time.perf_counter()
            shot, first = (
                (first, None)
                if first is not None
                else (self.take_shot(layout, T, area=area, paint="bins" if check else True), None)
            )
            if self._layout_changed.is_set():  # changes from the page (also during the photo)
                self._layout_changed.clear()
                layout = self.layout()
                planner.layout = layout
                self.note("layout changes applied")
            if self._ok.is_set():  # a bin was changed: this photo shows what stands there now
                self._ok.clear()
                self._resolve_requests(layout, shot, T)
                self._add_seen_bins(layout, shot, T)  # also bins put anywhere else
                planner.claims = self.claims
                prev = None
            with self._claims_lock:
                before = dict(self.claims)
                ok = prev is None or planner.report(prev, shot.parts)
                if self.claims != before:
                    self._save_claims()
                    mk = next(k for k in self.claims if before.get(k) != self.claims[k])
                    self.note(f"wild bin {mk} now collects {self.claims[mk]}")
                    self.say(f"bin {mk} now holds {self.claims[mk]}")
            if not ok and prev is not None and prev.part is not None:
                self.say(f"missed {prev.part.cls}: try again")
            if not ok:
                self.note(
                    f"pick of {prev.part.cls if prev and prev.part else '?'} failed: the part is still there"
                )
            if ok and prev is not None and prev.kind == "pick" and prev.bin is not None:
                with self._claims_lock:
                    mk = prev.bin.marker
                    self.bin_counts[mk] = self.bin_counts.get(mk, 0) + 1
                    if prev.part is not None:
                        vol = part_volume_mm3(prev.part, self.m.run.fill, self.volumes)
                        self.bin_volume[mk] = self.bin_volume.get(mk, 0.0) + vol
                        self.bin_family[mk] = family(prev.part.cls)
                    self._save_claims()
            self._set(
                counts=dict(planner.sorted_count),
                failed_picks=planner.failed_picks,
                picks=sum(planner.sorted_count.values()),
            )
            self._update_ready(planner, layout, shot.parts)
            planner.full = {mk for mk, f in self.bin_fill(layout).items() if f["full"]}
            self._say_seen(shot.parts, layout)
            here = tuple(self.motion.current_tip()[:2])
            plan = planner.next(shot.parts, here)  # type: ignore[arg-type]
            self._set(plan=_describe(plan), target=self._target(plan, layout))
            if steps is not None and done_steps >= steps:  # the next part is shown, not taken
                return "steps"
            if plan.note:
                self.note(plan.note)
                self.say(plan.note)
            self._ask_bins(planner, layout, shot.parts)
            if plan.kind == "wait_bin" and self._look_for_bins(layout, T):
                prev = None  # an empty bin turned up (not seen before): plan again with it
                continue
            if plan.kind == "wait_bin":  # everything else is sorted: only a bin change helps
                asked = "; ".join(r.text() for r in self.requests) or plan.reason
                if asked != waiting_for:  # say it once, not on every look
                    waiting_for = asked
                    self.note(f"waiting for a bin change: {plan.reason}")
                    self.say("waiting: " + asked)
                    self.motion.message("Change bin: press it")
                self._set(status="waiting", message=asked + "; press Change bin to park")
                # look again now and then: parts thrown in meanwhile are sorted while it waits
                end = time.monotonic() + self.m.standby.interval_s
                while (
                    not (self._park.is_set() or self._ok.is_set())
                    and not self._stop.is_set()
                    and time.monotonic() < end
                ):
                    time.sleep(0.2)
                self._set(status="running")
                prev = None
                continue
            waiting_for = ""
            if plan.kind == "done":
                self._set(status="done", message=plan.reason)
                self.note(f"done: {plan.reason}")
                self.say("done: " + plan.reason)
                self.motion.message("Sortering PNP: done")
                return "done"
            if plan.kind == "stuck":
                self.note(plan.reason)
                self.say("stuck: " + plan.reason)
                self.motion.message("Sortering PNP: needs a hand")
                if auto:
                    self._set(
                        status="stuck", message=plan.reason + "; waiting until they are moved"
                    )
                    return "stuck"
                self._set(status="stuck", message=plan.reason + "; then press resume")
                self._pause.set()
                while self._pause.is_set() and not self._stop.is_set():
                    time.sleep(0.2)
                planner.shakes_in_row = 0
                prev = None
                first = None
                self._set(status="running")
                continue
            if plan.kind == "shake":
                self.say("shake the bed: " + plan.reason.split(":")[0])
                with self._lock:
                    self.note(plan.reason)
                    self.motion.shake()
            else:
                with self._lock:
                    self._pick(plan, layout)
                    self._drop(plan, layout)
                self._set(timing={"cycle_s": round(time.perf_counter() - t0, 2)})
            prev = plan  # the next photo shows whether the pick worked
            done_steps += 1
        return "stopped"

    def _turbo_now(self, c: _RunCtx) -> bool:
        """Turbo (run.mode) for this run: not for One pick, the kit (counted on each photo) nor
        the head camera (its photos are many and cannot wait)."""
        return (
            self.m.run.mode == "turbo"
            and c.steps is None
            and c.planner.strategy != "kit"
            and self.m.camera.source != "head"
            and hasattr(self.vision, "snap")
            and hasattr(self.vision, "analyse")
        )

    def _snap(self, layout: Layout, T: Transform2D | None) -> Callable[[], Shot]:
        """Turbo's photo: park and take it (the page shows it at once); its analysis is
        returned, to run while the machine goes on picking."""
        work = self._work_area(layout, T)
        heights = lambda mid: _marker_plate_height(layout, mid)  # noqa: E731
        with self._lock:
            self.phase("parking at the photo position")
            self.motion.photo_position()
            name = self._photo_name()
            self.phase("taking a photo")
            with self.lights.for_photo():
                photo = self.vision.snap(name)
            self._show_photo(photo, name)

        def analyse() -> Shot:
            try:
                shot = (
                    self.vision.analyse(photo, name, heights, work)
                    if work is not None
                    else self.vision.analyse(photo, name, heights)
                )
            finally:
                self._set(analysing=False)
            return self._finish_shot(shot, layout, T)

        return analyse

    def _turbo_absorb(self, c: _RunCtx, shot: Shot, checks: list[Plan]) -> None:
        """A turbo photo's results: each pick made before it is checked (did it work?) and
        counted, then everything the single loop does with a new photo (bins, census)."""
        planner, layout = c.planner, c.layout
        missed = []
        for plan in checks:
            with self._claims_lock:
                ok = planner.report(plan, shot.parts)
                if ok and plan.kind == "pick" and plan.bin is not None:
                    mk = plan.bin.marker
                    self.bin_counts[mk] = self.bin_counts.get(mk, 0) + 1
                    if plan.part is not None:
                        vol = part_volume_mm3(plan.part, self.m.run.fill, self.volumes)
                        self.bin_volume[mk] = self.bin_volume.get(mk, 0.0) + vol
                        self.bin_family[mk] = family(plan.part.cls)
            if not ok and plan.part is not None:
                missed.append(plan.part.cls)
        if checks:
            with self._claims_lock:
                self._save_claims()
        for cls in missed:
            self.note(f"pick of {cls} failed: the part is still there")
            self.say(f"missed {cls}: try again")
        self._set(
            counts=dict(planner.sorted_count),
            failed_picks=planner.failed_picks,
            picks=sum(planner.sorted_count.values()),
        )
        self._update_ready(planner, layout, shot.parts)
        planner.full = {mk for mk, f in self.bin_fill(layout).items() if f["full"]}
        self._say_seen(shot.parts, layout)
        self._ask_bins(planner, layout, shot.parts)

    def _turbo_loop(self, c: _RunCtx) -> str:
        """Turbo: run.turbo_picks picks from one photo, then a photo, analysed in the background
        while it goes on picking from the same list; its results replace the list when they
        come. A part within run.turbo_keep_away_mm of a pick made since its photo waits for the
        next photo (it may have been nudged), so the picks from one photo are spread apart.
        Every pick is checked by the first photo taken after it. Pause, Change bin, layout
        changes and a list with nothing left to pick go to the single loop ("single"), which
        comes back here from its next photo."""
        run = self.m.run
        planner = c.planner
        pool = ThreadPoolExecutor(max_workers=1, thread_name_prefix="turbo-analysis")
        pending: Future[Shot] | None = None
        checked_by_pending: list[Plan] = []  # the picks the photo in flight will check
        unchecked: list[Plan] = []  # picks made since the last photo was taken
        near: list[tuple[float, float]] = []  # picks made since the list's own photo
        made = 0  # picks since the last photo was taken

        def take_now() -> Shot:
            nonlocal unchecked, near, made
            shot = self.take_shot(c.layout, c.T)
            self._turbo_absorb(c, shot, unchecked)
            unchecked, near, made = [], [], 0
            return shot

        def landed(shot: Shot) -> list[Part]:
            nonlocal checked_by_pending, near
            self._turbo_absorb(c, shot, checked_by_pending)
            checked_by_pending = []
            near = [p.part.bed_xy for p in unchecked if p.part is not None]  # after that photo
            return list(shot.parts)

        try:
            if c.first is not None:
                shot, c.first = c.first, None
                self._turbo_absorb(c, shot, [c.prev] if c.prev is not None else [])
            else:
                if c.prev is not None:
                    unchecked = [c.prev]
                shot = take_now()
            c.prev = None
            parts = list(shot.parts)
            if c.turbo_said != run.turbo_picks:  # said once (and when the number changes)
                c.turbo_said = run.turbo_picks
                self.note(f"turbo: {run.turbo_picks} picks per photo")
            while not self._stop.is_set():
                if (
                    self._pause.is_set()
                    or self._park.is_set()
                    or self._ok.is_set()
                    or self._layout_changed.is_set()
                    or not self._turbo_now(c)
                ):  # finish what is in flight; the single loop deals with it
                    if pending is not None:
                        landed(pending.result())
                        pending = None
                    if unchecked:
                        c.first = None if self._pause.is_set() else take_now()
                    return "single"
                if pending is not None and pending.done():
                    parts = landed(pending.result())
                    pending = None
                if made >= run.turbo_picks and pending is None:
                    pending = pool.submit(self._snap(c.layout, c.T))
                    checked_by_pending, unchecked, made = unchecked, [], 0
                keep = run.turbo_keep_away_mm
                cands = [p for p in parts if all(_dist(p.bed_xy, q) > keep for q in near)]
                here = tuple(self.motion.current_tip()[:2])
                plan = planner.next(cands, here)  # type: ignore[arg-type]
                if plan.kind == "pick" and plan.part is not None:
                    self._set(plan=_describe(plan), target=self._target(plan, c.layout))
                    if plan.note:
                        self.note(plan.note)
                        self.say(plan.note)
                    t0 = time.perf_counter()
                    with self._lock:
                        self._pick(plan, c.layout)
                        self._drop(plan, c.layout)
                    self._set(timing={"cycle_s": round(time.perf_counter() - t0, 2)})
                    if plan.claim is not None and plan.bin is not None:
                        # held for this kind from now on: the next picks of it go there too
                        with self._claims_lock:
                            if self.claims.get(plan.bin.marker) != plan.claim:
                                self.claims[plan.bin.marker] = plan.claim
                                self._save_claims()
                                self.note(f"wild bin {plan.bin.marker} now collects {plan.claim}")
                                self.say(f"bin {plan.bin.marker} now holds {plan.claim}")
                    unchecked.append(plan)
                    near.append(plan.part.bed_xy)
                    parts = [p for p in parts if p is not plan.part]
                    made += 1
                    c.done_steps += 1
                    continue
                # nothing to pick from this list
                if pending is not None:  # the next photo is on its way: wait for it
                    self.phase("waiting for the photo's analysis")
                    parts = landed(pending.result())
                    pending = None
                    continue
                if near or unchecked:  # the list is out of date: a fresh photo first
                    parts = list(take_now().parts)
                    continue
                # a fresh list and still nothing to pick: done, stuck, a shake or a bin change
                c.first = self.last_shot
                return "single"
            return "stopped"
        finally:
            pool.shutdown(wait=False)

    def _z_limit_note(self) -> None:
        """Once: Klipper caps every Z move at its max_z_velocity; say so when that is below the
        Z speed asked for (printer.feed_z_empty at this speed)."""
        if getattr(self, "_z_noted", False):
            return
        self._z_noted = True
        limit = getattr(self.printer, "z_velocity_limit", lambda: None)()
        want = self.m.printer.feed_z_empty * self.motion.speed / 60.0
        if limit is not None and want > limit + 0.05:
            self.note(
                f"Klipper caps Z at {limit:g} mm/s (printer.cfg [printer] max_z_velocity): "
                f"the empty Z moves run at that, not {want:.0f} mm/s"
            )

    # ------------------------------------------------------------------ automatic mode
    def _wait(self, seconds: float, wake: bool = False) -> bool:
        """Sleep, waking up for stop (and with `wake`, for Resume/Start: look now); True when
        stopped."""
        end = time.monotonic() + max(0.0, seconds)
        while not self._stop.is_set():
            left = end - time.monotonic()
            if left <= 0 or (wake and (self._now.is_set() or self._park.is_set())):
                return False
            self._stop.wait(min(left, 0.2))
        return True

    def _bin_change_standby(self) -> bool:
        """Change bin pressed while automatic mode stands by: park, wait for the second press,
        then a photo of the bins checks them. True when stopped."""
        if self._park.is_set():
            self._park.clear()
            st = self.printer.status(None)
            homed = st.ready and all(a in st.homed for a in "xyz")
            if self._parked_for_bins(move=homed):  # not homed: standby left it parked
                return True
        if self._ok.is_set():
            self._ok.clear()
            self._now.clear()
            layout, T = self._prepare()
            st = self.printer.status(None)
            homed = st.ready and all(a in st.homed for a in "xyz")
            shot = self.take_shot(layout, T, move=homed, area="bins", paint="bins")
            for text in self._resolve_requests(layout, shot, T):
                self.say(text)
            self._add_seen_bins(layout, shot, T)
        return False

    def _look(self) -> tuple[Shot, list[Any], Layout]:
        """A standby photo. With the motors off nothing moves: the bed is still parked out."""
        layout, T = self._prepare()
        st = self.printer.status(None)
        homed = st.ready and all(a in st.homed for a in "xyz")
        if self.m.camera.source == "head" and not homed:  # it must move to look
            with self._lock:
                self.motion.preflight()
        shot = self.take_shot(layout, T, move=homed)
        margin = self.m.run.work_margin_mm
        return shot, [p for p in shot.parts if layout.in_work(p.bed_xy, margin)], layout

    def _can_reuse_look(self) -> bool:
        """May the run start from the standby photo? Not when the bed must home first (motors
        off: homing moves the bed and can shift the parts), nor with a head camera (a standby
        look covers only the tray, the run's first photo the bins too)."""
        if self.m.camera.source == "head":
            return False
        st = self.printer.status(None)
        return st.ready and all(a in st.homed for a in "xyz")

    def _auto(self, strategy: str) -> None:
        """Standby: look for parts every standby.interval_s; when some lie on the plate, sort
        them at once; then wait again. Runs until Stop (or too many errors in a row)."""
        self._in_auto = True
        try:
            if self.m.run.startup_check and not self._started_up:
                self._start_up()
            self._auto_loop(strategy)
        except Exception as exc:  # noqa: BLE001 - the start-up check failed: shown on the page
            if self._started_up:
                raise
            log.exception("start-up check")
            self.note(f"start-up check failed: {exc}")
            self._set(status="error", message=f"start-up check failed: {exc}")
        finally:
            self._in_auto = False
            self._next_look = None

    def _auto_loop(self, strategy: str) -> None:
        sb = self.m.standby
        tried: list[Any] | None = None  # the parts of a stuck plate: wait until they change
        errors = 0
        self.note(f"automatic mode on: {STRATEGIES[strategy]}")
        self.phase("automatic: waiting for parts")
        self._now.clear()
        while not self._stop.is_set():
            try:
                if self._pause.is_set():
                    self._set(status="paused", message="automatic mode paused")
                    while self._pause.is_set() and not self._stop.is_set():
                        time.sleep(0.2)
                    tried = None
                    continue
                if self._park.is_set() or self._ok.is_set():  # Change bin while standing by
                    if self._bin_change_standby():
                        break
                    continue
                now = self._now.is_set()  # Resume / Start: sort what is there, at once
                self._now.clear()
                if now:
                    tried = None
                shot, parts, _ = self._look()
                # parts on the plate don't move by themselves: sort them at once, no second look
                if len(parts) >= sb.min_parts and not (
                    tried is not None and same_parts(parts, tried)
                ):
                    self.say(f"{len(parts)} part(s) seen: sorting")
                    outcome = self._sort(
                        strategy, None, auto=True, looked=shot if self._can_reuse_look() else None
                    )
                    tried = None
                    if outcome == "stuck" and self.last_shot is not None:
                        _, tried, _ = self._look()
                    if outcome == "stopped":
                        break
                    if sb.motors_off and self.m.camera.source != "head":
                        with self._lock:
                            self.motion.motors_off()
                    errors = 0
                    continue  # look again at once: more parts may have arrived meanwhile
                errors = 0
                status = "stuck" if tried is not None else "standby"
                msg = "parts need a hand" if tried is not None else "waiting for parts"
                self._next_look = time.time() + sb.interval_s  # the page counts down to it
                self._set(
                    status=status,
                    message=f"{msg} · next look in {round(sb.interval_s)} s (Look now: at once)",
                )
                stopped = self._wait(sb.interval_s, wake=True)
                self._next_look = None
                if stopped:
                    break
            except Exception as exc:  # noqa: BLE001 - shown on the page; standby keeps trying
                errors += 1
                log.exception("automatic mode")
                self.note(f"error ({errors}/{sb.max_errors}): {exc}")
                self._set(status="error", message=str(exc))
                if errors >= sb.max_errors:
                    self.note("automatic mode switched off after repeated errors")
                    self._save_mode(False)
                    return
                if self._wait(sb.interval_s):
                    break
        self._set(status="idle", message="automatic mode off")

    # ------------------------------------------------------------------ remembered settings
    @property
    def state_path(self) -> Path:
        p = self.m.path(self.m.paths.state)
        assert p is not None
        return p

    def _save_mode(self, auto: bool, strategy: str | None = None) -> None:
        write_json(self.state_path, {"auto": auto, "strategy": strategy or self.state.strategy})

    def saved_mode(self) -> tuple[bool, str]:
        """Was automatic mode on when the program stopped? (it is switched on again at start)"""
        if not self.state_path.is_file():
            return False, self.m.run.strategy
        d = read_json(self.state_path) or {}
        return bool(d.get("auto")), str(d.get("strategy") or self.m.run.strategy)

    def shutdown(self) -> None:
        """The program ends: stop after this move, but remember automatic mode for the restart."""
        self._stop.set()
        self._pause.clear()
        self.wait(30)
        self.pins.close()
        self.lights.close()

    def _load_tool(self) -> None:
        p = self.m.path(self.m.paths.tool)
        if p is not None and p.is_file():
            d = read_json(p) or {}
            if "offset_z" in d:
                self.m.tool.offset[2] = float(d["offset_z"])
                if "surface_z" in d:
                    self._tip_touch = (float(d["offset_z"]), float(d["surface_z"]))

    def _follow_surface(self, layout: Layout) -> None:
        """The tip was touched on the surface the parts lie on, so that stays the height picks
        count from when the number for it changes later (the TPU sheet field)."""
        if self._tip_touch is None:
            return
        offset, surface = self._tip_touch
        z = round(offset + layout.surface_z() - surface, 3)
        if z != self.m.tool.offset[2]:
            self.m.tool.offset[2] = z
            self.motion.tip = None

    def tip_touches_plate(self) -> dict[str, Any]:
        """The tip was jogged down until it just touches the surface the parts lie on: from now on
        that is `surface_z()`, whatever Z the homing gives (see "Homing" in docs/reference.md)."""
        self._idle()
        layout = self.layout()
        with self._lock:
            pos = self.printer.status(None).position
            self.motion.tip = None
        surface = round(layout.surface_z(), 3)
        offset_z = round(surface - pos[2], 3)
        p = self.m.path(self.m.paths.tool)
        assert p is not None
        write_json(
            p,
            {
                "offset_z": offset_z,
                "toolhead_z": pos[2],
                "surface_z": surface,  # the printer Z the touched surface was taken to be
                "measured": time.strftime("%Y-%m-%d %H:%M:%S"),
            },
        )
        self.m.tool.offset[2] = offset_z
        self._tip_touch = (offset_z, surface)
        self.setup.mark("tip", f"offset {offset_z:+.2f} mm")
        self.note(
            f"tip height: touches the plate (Z {surface:.2f}) at toolhead Z {pos[2]:.2f} "
            f"(offset {offset_z:+.2f} mm)"
        )
        return {"offset_z": offset_z, "toolhead_z": pos[2], "surface_z": surface}

    def _pick(self, plan: Plan, layout: Layout) -> None:
        p, b = plan.part, plan.bin
        assert p is not None and b is not None
        pk = self.m.picker
        surface = layout.surface_z()
        if pk.kind.holds == "jaws":
            h = p.grip_height_mm if p.grip_height_mm is not None else p.top_mm * pk.grip_height
            z = surface + h
        elif pk.kind.holds == "cup":  # the cup goes down over the part: its size doesn't matter
            z = surface + pk.cup_above_mm
        else:
            z = surface + p.top_mm - pk.depth_mm
        if pk.kind.holds != "cup":
            z = max(z, surface + 0.3)
        x, y = p.grip_bed if p.grip_method != "centre" else p.bed_xy
        jaws = jaw_angle(p.bed_angle, pk.rotate_offset_deg)
        name = p.cls + (f"x{p.length_mm:g}" if p.length_mm is not None else "")
        self.note(
            f"pick {name} at ({x:.1f}, {y:.1f}) Z{z:.2f} (top {p.top_mm:.1f}) "
            f"-> bin {b.marker} ({plan.reason})"
        )
        turn = f", jaws {jaws:.0f}°" if pk.kind.rotates else ""
        self.phase(f"picking {name} at X{x:.0f} Y{y:.0f}{turn}, for bin {layout.bin_name(b)}")
        self.motion.message(f"pick {name}")
        top = surface + p.top_mm if pk.kind.holds == "cup" else None
        self.motion.pick(x, y, z, jaws, top=top)

    def _drop(self, plan: Plan, layout: Layout) -> None:
        b = plan.bin
        assert b is not None
        cx, cy = layout.drop_centre(b)  # where the camera saw it, not only its grid cells
        p = plan.part
        name = (p.cls + (f"x{p.length_mm:g}" if p.length_mm is not None else "")) if p else "it"
        self.phase(f"leaving {name} in bin {layout.bin_name(b)} ({b.marker})")
        # a bin at the bed's edge: its opening's middle may be just out of reach. Half a shelf's
        # depth still lets the part go over the opening; further out the move is refused
        cx, cy = self.motion.within_reach(cx, cy, binspec.SHELF_DEPTH_MM / 2)
        self.motion.drop(cx, cy, layout.bin_rim_z(b))

    # ------------------------------------------------------------------ web-page helpers
    def _idle(self) -> None:
        if self._thread is not None and self._thread.is_alive():
            raise PrinterError("the sorter is running: stop it first")

    def jog(self, dx: float, dy: float, dz: float) -> list[float]:
        self._idle()
        with self._lock:
            self.motion.preflight(home=False)
            return [round(v, 3) for v in self.motion.jog(dx, dy, dz)]

    def tip(self) -> list[float]:
        with self._lock:
            self.motion.tip = None
            return [round(v, 3) for v in self.motion.current_tip()]

    def calib_photo(self) -> list[dict[str, Any]]:
        self._idle()
        layout = self.layout()
        cal = self.calibration()
        with self._lock:
            self.motion.preflight(home=False)
        shot = self.take_shot(layout, cal.transform if cal else None, area="here", paint=False)
        out = []
        for mk in sorted(shot.markers, key=lambda m: m.marker):
            size = binspec.size_for_marker(mk.marker)
            d: dict[str, Any] = {
                "marker": mk.marker,
                "plate": [round(v, 2) for v in mk.centre],
                "what": size.name if size else "calibration board" if mk.marker < 50 else "?",
                "view_px": [round(v, 1) for v in mk.view_px] if mk.view_px else None,
            }
            if cal is not None:
                d["bed"] = [round(float(v), 2) for v in cal.transform.apply(mk.centre)]
            out.append(d)
        self._calib_markers = out
        self.say(f"camera: {len(out)} code(s) seen" if out else "camera: no codes seen")
        return out

    def calib_record(self, marker: int) -> dict[str, Any]:
        """Pair the camera's view of `marker` with where the tool tip is now (jogged onto it)."""
        if self.last_shot is None:
            raise PrinterError("take a calibration photo first")
        mk = next((x for x in self.last_shot.markers if x.marker == marker), None)
        if mk is None:
            raise PrinterError(f"marker {marker} was not in the last photo")
        tip = self.tip()
        for p in self.calib_pairs:
            far = math.dist(p["plate"], mk.centre) > MIN_SPREAD_MM
            if p["marker"] != marker and far and math.dist(p["bed"], tip[:2]) < 5.0:
                raise PrinterError(
                    f"the tip is where it was for code {p['marker']}: jog it onto the centre of "
                    f"code {marker} first"
                )
        self.calib_pairs = [p for p in self.calib_pairs if p["marker"] != marker]
        pair = {"marker": marker, "plate": [round(v, 3) for v in mk.centre], "bed": tip[:2]}
        self.calib_pairs.append(pair)
        self.note(
            f"calibration point: marker {marker} plate {pair['plate']} -> printer {pair['bed']}"
        )
        return pair

    def calib_fit(self) -> dict[str, Any]:
        if len(self.calib_pairs) < 3:
            raise PrinterError("record at least 3 markers (spread over the bed)")
        try:
            cal = BedCalibration.fit(self.calib_pairs)
        except ValueError as exc:
            self.setup.reset("camera")
            self._calib_fit = None  # an old fit's line would read as this one's
            raise PrinterError(str(exc)) from exc
        cal.save(self.transform_path)
        worst = max(cal.residuals_mm)
        self.note(f"calibrated: {len(self.calib_pairs)} points, worst error {worst:.2f} mm")
        if worst < 1.0:
            self.setup.mark("camera", f"{len(self.calib_pairs)} points, worst {worst:.2f} mm")
        else:
            self.setup.reset("camera")
        self._calib_fit = {
            "residuals_mm": cal.residuals_mm,
            "worst_mm": round(worst, 2),
            "angle_deg": round(cal.transform.angle_deg, 3),
            "scale": round(cal.transform.scale, 5),
        }
        return self._calib_fit

    def calib_clear(self) -> None:
        self.calib_pairs = []
        self._calib_fit = None

    def goto_marker(self, marker: int) -> list[float]:
        """Check the calibration: put the tip 2 mm above a marker."""
        self._idle()
        if self.last_shot is None:
            raise PrinterError("take a calibration photo first")
        mk = next((x for x in self.last_shot.markers if x.marker == marker), None)
        if mk is None:
            raise PrinterError(f"marker {marker} was not in the last photo")
        layout = self.layout()
        T = self.transform()
        x, y = (float(v) for v in T.apply(mk.centre))
        b = layout.bin_by_marker(marker)
        z = layout.marker_z(b.height_u if b else 3) + 2.0
        with self._lock:
            self.motion.preflight(home=False)
            self.motion.travel(x, y)
            self.motion.move(z=z)
            self.printer.gcode("M400")
        return [round(x, 2), round(y, 2), round(z, 2)]

    def goto_point(self, marker: int) -> list[float]:
        """Move tip here: back to where the tip was recorded for `marker` (Tip is here), 2 mm
        above the code, to see whether the point was taken on its centre."""
        self._idle()
        pair = next((p for p in self.calib_pairs if p["marker"] == marker), None)
        if pair is None:
            raise PrinterError(f"no point recorded for code {marker}: Tip is here first")
        layout = self.layout()
        b = layout.bin_by_marker(marker)
        x, y = (float(v) for v in pair["bed"])
        z = layout.marker_z(b.height_u if b else 3) + 2.0
        with self._lock:
            self.motion.preflight(home=False)
            self.motion.travel(x, y)
            self.motion.move(z=z)
            self.printer.gcode("M400")
        self.say(f"tip over the point recorded for code {marker}")
        return [round(x, 2), round(y, 2), round(z, 2)]

    def scan_bins(self) -> dict[str, Any]:
        """Photo, then put every bin whose marker is seen where it really is. While the sorter
        runs it stops first (after the move in progress) and carries on afterwards."""
        if self._thread is not None and self._thread.is_alive():
            parked = self._in_auto and self.state.status in ("standby", "stuck")
            return {"queued": self._take_over("resync", lambda: self._scan_in_thread(parked))}
        return self._scan_now()

    def _scan_in_thread(self, parked: bool) -> str:
        """`parked`: automatic mode stood by, the bed parked out (maybe with the motors off)."""
        st = self.printer.status(None)
        homed = st.ready and all(a in st.homed for a in "xyz")
        r = self._scan_now(parked and not homed)
        return f"resync: {len(r['found'])} bin(s)" + (
            f", not seen: {', '.join(map(str, r['removed']))}" if r["removed"] else ""
        )

    def _scan_now(self, parked: bool = False) -> dict[str, Any]:
        """`parked`: photograph where the bed stands (standby parked it), no move."""
        layout = self.layout()
        T = self.transform()
        if not parked:
            with self._lock:
                self.motion.preflight(home=False)
        shot = self.take_shot(layout, T, move=not parked, area="bins", paint="bins")
        report = layout.resync(self._seen_bins(layout, shot, T))
        layout.save(self.layout_path)
        checked = None
        if getattr(self.vision, "model_missing", lambda: None)() is None:
            self.phase("looking into the bins")
            checked = self._bins_check(layout, shot, T)
        wb = layout.work_bin()
        plate = f"bin {wb.marker} ({wb.w}x{wb.d})" if wb else "none"
        self.note(
            f"resync: {len(report['found'])} bin(s), grid at {report['origin']}, plate {plate}"
            + (f", not seen: {report['removed']}" if report["removed"] else "")
        )
        problems = layout.problems()
        if report["found"] and wb is not None and not problems:
            self.setup.mark("layout", f"{len(report['found'])} bins, plate {wb.marker}")
        else:
            self.setup.reset("layout")
        bins = [{"marker": b.marker, "x": b.x, "y": b.y, "rot": b.rot} for b in layout.bins]
        return {**report, "bins": bins, "problems": problems, "bins_check": checked}

    # ------------------------------------------------------------------ the Setup tab
    MACHINE_KEYS = (
        "photo_position",
        "change_position",
        "travel_z",
        "limits_x",
        "limits_y",
        "limits_z",
        "home_corner",
    )

    def _load_machine(self) -> None:
        p = self.m.path(self.m.paths.machine)
        if p is None or not p.is_file():
            return
        for k, v in (read_json(p) or {}).items():
            if k in self.MACHINE_KEYS:
                setattr(self.m.printer, k, v)
            elif k == "mask_margin_mm":
                self.m.camera.mask_margin_mm = float(v)
                self.mask_checked = True
            elif k == "speed_pct":  # Device tab: Speed
                self.m.run.speed_pct = float(v)
            elif k == "run_mode" and v in RUN_MODES:  # Device tab: Mode
                self.m.run.mode = str(v)
            elif k == "turbo_picks":
                self.m.run.turbo_picks = max(1, int(v))
            elif k == "bins_margin_mm":  # Calibrate tab: Bins view
                self.m.camera.bins_margin_mm = float(v)
            elif k == "bins_mask":
                self.m.camera.bins_mask = bool(v)
            elif k == "mask_colour":  # Camera cropping, Calibrate tab
                self.m.camera.mask_colour = str(v)
            elif k in ("camera_hflip", "camera_vflip", "camera_turn90"):  # Rotate / Mirror
                setattr(self.m.camera, k.removeprefix("camera_"), bool(v))
            elif k == "camera_adjust":  # Camera Calibration tab: focus, colours, exposure
                a = self.m.camera.adjust
                for ak, av in (v or {}).items():
                    if hasattr(a, ak):
                        setattr(a, ak, type(getattr(a, ak))(av))
            elif k == "camera_height_mm":  # Calibrate tab, Skip for now
                self.m.camera.height_mm = float(v)
            elif k == "picker_mode":  # chosen in the Setup tab
                self.m.picker.set_type(str(v))
            elif k == "rotate_offset_deg":
                self.m.picker.rotate_offset_deg = float(v)
            elif k == "lower_to_drop":  # Setup tab, Picker step
                self.m.picker.lower_to_drop = bool(v)
            elif k == "pump_switch" and v in PUMP_SWITCHES:  # Setup tab, Picker step
                self.m.picker.pump_switch = str(v)
            elif k == "lights" and isinstance(v, dict):  # Setup tab, Lights step
                for name in self.LIGHT_KEYS:
                    if name in v:
                        setattr(self.m.lights, name, type(getattr(self.m.lights, name))(v[name]))
            elif k == "camera_settings":  # locked in the Calibrate tab
                self.m.camera.settings = str(v)
            elif k == "calibration":
                c = self.m.calibration
                c.measured_square_mm = v.get("measured_square_mm", c.measured_square_mm)
                c.board_thickness_mm = float(v.get("board_thickness_mm", c.board_thickness_mm))

    def machine_values(self) -> dict[str, Any]:
        return {k: getattr(self.m.printer, k) for k in self.MACHINE_KEYS}

    def save_machine(self, values: dict[str, Any]) -> dict[str, Any]:
        """Limits, travel height and photo position from the Setup tab (kept in data/
        machine.json, over machine.yaml). Un-checks the Machine step: confirm it again."""
        self._idle()
        new = self.machine_values()
        for k, v in values.items():
            if k not in self.MACHINE_KEYS:
                raise ValueError(f"unknown machine value {k!r}")
            if k == "travel_z":
                new[k] = float(v)
            elif k == "home_corner":
                if v not in HOME_CORNERS:
                    raise ValueError(f"home_corner must be one of {', '.join(HOME_CORNERS)}")
                new[k] = v
            else:
                vals = [float(x) for x in v]
                position = k.endswith("_position")
                if len(vals) != (3 if position else 2):
                    raise ValueError(f"{k}: wrong number of values")
                if not position and not vals[0] < vals[1]:
                    raise ValueError(f"{k}: the minimum must be below the maximum")
                new[k] = vals
        old = self.machine_values()
        for k, v in new.items():
            setattr(self.m.printer, k, v)
        try:
            for key in ("photo_position", "change_position"):
                x, y, z = new[key]
                self.motion.check(x, y, z)
                self.motion.check(x, y, new["travel_z"])
        except PrinterError:
            for k, v in old.items():
                setattr(self.m.printer, k, v)
            raise
        p = self.m.path(self.m.paths.machine)
        assert p is not None
        kept = read_json(p) if p.is_file() else {}  # e.g. the tray view's margin
        write_json(p, {**kept, **new})
        self.setup.reset("machine")
        self.note("machine values saved: confirm them in the Setup tab")
        return self.setup_state()

    def setup_state(self) -> dict[str, Any]:
        return {
            "steps": self.setup.state(),
            "required": self.require_setup,
            "complete": not self.setup.missing(),
            "machine": self.machine_values(),
            "photo_z": self.motion.photo_z(),  # the Z photos are really taken at
            "homed_now": self._setup_homed,
            "picker_tried": sorted(self._setup_picker),
            "tool": self._tool,  # the mounted tool, as Klipper last said (None: not asked yet)
            "tip_offset_z": self.m.tool.offset[2],
            "camera": {
                "calibrated": self._camera_calibrated(),
                "markers": self._calib_markers,
                "pairs": self.calib_pairs,
                "fit": self._calib_fit,
                "view": self.state.view,
                "view_h": self.state.view_h,
            },
            "rotation": self.m.picker.kind.rotates,
            "lights": self.lights.state(),
            "picker": {
                "mode": self.m.picker.kind.key,
                "types": [pickers.as_dict(t) for t in pickers.PICKERS],
                "offset_deg": self.m.picker.rotate_offset_deg,
                "lower_to_drop": self.m.picker.lower_to_drop,
                "drop_mm": self.m.picker.drop_mm,
                "action_pin": self.m.picker.action_pin,
                "turn_pin": self.m.picker.turn_pin,
                "pump_switch": self.m.picker.pump_switch,
                "pump_switches": list(PUMP_SWITCHES),
                "pump_heater_target": self.m.picker.pump_heater_target,
                "pins": dict(zip(("ok", "message"), self.pins.status(), strict=True)),
            },
        }

    def _camera_calibrated(self) -> str | None:
        """Where the camera calibration (the board in the tray) comes from, or None."""
        key = "head_calibration" if self.m.camera.source == "head" else "calibration"
        path, source = files_mod.find(self.m, key)
        return source if path is not None else None

    def setup_picker_type(self, mode: str) -> dict[str, Any]:
        """The kind of picker (Setup tab): how it takes a part, where it aims, whether it turns.
        Un-checks the Picker step: test it again. The pins follow the type by themselves."""
        self._idle()
        t = pickers.picker_type(mode)
        self.m.picker.set_type(t.key)
        self.remember_machine({"picker_mode": t.key})
        self.setup.reset("picker")
        self._setup_picker.clear()
        self.note(
            f"picker: {t.title} (aims at the {'head' if t.aim == 'head' else 'centre of gravity'})"
        )
        return self.setup_state()

    def setup_picker_pump(self, switch: str) -> dict[str, Any]:
        """What switches a pump (Setup tab): a MOSFET module on the Pi's pin, or the printer
        board's bed or hotend output through Klipper. Un-checks the Picker step."""
        self._idle()
        if switch not in PUMP_SWITCHES:
            raise ValueError(f"the pump switch must be one of {PUMP_SWITCHES}")
        self.pins.off()  # let go through the old switch before the pins follow the new one
        self.m.picker.pump_switch = switch
        self.remember_machine({"pump_switch": switch})
        self.setup.reset("picker")
        self._setup_picker.clear()
        where = (
            "a MOSFET module on the Pi" if switch == "mosfet" else f"the board's {switch} output"
        )
        self.note(f"pump switched by {where}")
        return self.setup_state()

    def setup_picker_offset(self, deg: float) -> dict[str, Any]:
        """Trim of the rotation: the servo angle at which the jaws close along printer X."""
        self._idle()
        self.m.picker.rotate_offset_deg = float(deg) % 180.0
        self.remember_machine({"rotate_offset_deg": self.m.picker.rotate_offset_deg})
        self._setup_picker.discard("rotate")
        return self.setup_state()

    LIGHT_KEYS = ("enabled", "colour", "brightness", "always_on")

    def setup_lights(self, values: dict[str, Any]) -> dict[str, Any]:
        """Setup tab, Lights: colour (#RRGGBB), brightness (0..1), always on, enabled. Shown on
        the LEDs at once (a preview) and kept in machine.json. Switching them off (no lights)
        darkens them first."""
        li = self.m.lights
        new = {k: getattr(li, k) for k in self.LIGHT_KEYS}
        for k, v in values.items():
            if k not in self.LIGHT_KEYS:
                raise ValueError(f"unknown light value {k!r}")
            if k == "colour":
                parse_hex(str(v))
                new[k] = "#" + str(v).strip().lstrip("#").lower()
            elif k == "brightness":
                b = float(v)
                if not 0 <= b <= 1:
                    raise ValueError("brightness must be 0..1")
                new[k] = b
            else:
                new[k] = bool(v)
        if li.enabled and not new["enabled"]:
            self.lights.off()
        for k, v in new.items():
            setattr(li, k, v)
        self.remember_machine({"lights": new})
        if li.enabled:
            self.lights.preview()
        if not li.enabled and "enabled" in values:
            self.setup.reset("lights")
        return self.setup_state()

    def lights_preview(self, values: dict[str, Any]) -> dict[str, Any]:
        """Setup tab, Lights, while a bar moves: the colour on the LEDs at once, nothing saved
        and only a small answer, as it comes many times a second. setup_lights() keeps it
        when the bar is let go."""
        li = self.m.lights
        colour = str(values.get("colour", li.colour))
        parse_hex(colour)
        brightness = float(values.get("brightness", li.brightness))
        if not 0 <= brightness <= 1:
            raise ValueError("brightness must be 0..1")
        li.colour, li.brightness = "#" + colour.strip().lstrip("#").lower(), brightness
        if li.enabled:
            self.lights.preview()
        return {
            "colour": li.colour,
            "brightness": li.brightness,
            "shown": li.enabled,
            "error": self.lights.error,  # e.g. no /dev/spidev0.0: the LEDs got nothing
        }

    def setup_picker_drop(self, lower: bool) -> dict[str, Any]:
        """Over the bin: lower to rim + drop_mm before letting go, or let go at the travel
        height (the default). Kept in machine.json."""
        self._idle()
        self.m.picker.lower_to_drop = bool(lower)
        self.remember_machine({"lower_to_drop": self.m.picker.lower_to_drop})
        how = "lowered to the bin's rim" if lower else "at the travel height"
        self.note(f"parts are let go {how}")
        return self.setup_state()

    def setup_check_printer(self) -> dict[str, Any]:
        """Only questions to Klipper, nothing moves."""
        pc = self.m.printer
        checks: list[dict[str, Any]] = []
        try:
            st = self.printer.status(pc.tool_macro)
        except PrinterError as exc:
            checks.append({"what": "Moonraker answers", "ok": False, "detail": str(exc)})
            st = None
        if st is not None:
            checks.append(
                {"what": "Klipper is ready", "ok": st.ready, "detail": st.message or st.state}
            )
            if st.ready:
                if pc.tool_macro:  # which tool is on: the Picker step (it has the button)
                    self._tool = st.tool
                    checks.append(
                        {
                            "what": "sortering_pnp.cfg is included",
                            "ok": st.tool is not None,
                            "detail": "[include sortering_pnp.cfg] in printer.cfg",
                        }
                    )
                hot = st.hotend_c
                checks.append(
                    {
                        "what": "the hotend is cold",
                        "ok": hot is None or hot <= pc.max_hotend_c,
                        "detail": f"{hot} C",
                    }
                )
                checks.append({"what": "nothing is printing", "ok": not st.printing, "detail": ""})
        ok = bool(checks) and all(c["ok"] for c in checks)
        if ok:
            self.setup.mark("printer")
        else:
            self.setup.reset("printer")
        return {"ok": ok, "checks": checks, **self.setup_state()}

    def _ask_tool(self) -> str | None:
        """The tool Klipper has as mounted ("picker", "hotend"); None without a tool macro."""
        pc = self.m.printer
        if not pc.tool_macro:
            return None
        self._tool = self.printer.status(pc.tool_macro).tool
        return self._tool

    def setup_tool(self, tool: str) -> dict[str, Any]:
        """The person says which tool is on the printer (Setup tab, Picker): runs TOOL_PICKER
        or TOOL_HOTEND. Only a person can say it; nothing moves."""
        self._idle()
        pc = self.m.printer
        macro = {"picker": pc.tool_picker, "hotend": pc.tool_hotend}.get(tool)
        if macro is None:
            raise ValueError("tool must be picker or hotend")
        with self._lock:
            if tool == "hotend":
                self.pins.off()
            self.printer.gcode(macro)
            now = self._ask_tool()
        if pc.tool_macro and now != tool:
            raise PrinterError(
                f"Klipper still has {now!r} mounted: is sortering_pnp.cfg included (step 1)?"
            )
        self.say("picker on the printer" if tool == "picker" else "hotend back on: sorting refused")
        return self.setup_state()

    def setup_home(self) -> dict[str, Any]:
        """Home while the user watches: Z must come down over the middle of the plate."""
        self._idle()
        layout = self.layout()
        x0, y0, x1, y1 = layout.work_rect()
        with self._lock:
            self.motion.z_home_xy = ((x0 + x1) / 2, (y0 + y1) / 2)
            try:
                self.motion.preflight(home=False)
            except PrinterError as exc:
                if "not homed" not in str(exc):
                    raise
            self.motion.home()
            self.printer.gcode("M400")
        self._setup_homed = True
        self.note("homed from the Setup tab")
        return self.setup_state()

    def _limit_corners(self) -> dict[str, tuple[float, float]]:
        """The four corners of the soft limits, as tip X/Y. The corner the printer homes to
        has the X and Y minimum (printer.home_corner); the others follow from it."""
        pc = self.m.printer
        ox, oy, _ = self.m.tool.offset
        right, back = pc.home_corner.endswith("right"), pc.home_corner.startswith("back")
        x = {"left": pc.limits_x[1] if right else pc.limits_x[0]}
        x["right"] = pc.limits_x[0] if right else pc.limits_x[1]
        y = {"front": pc.limits_y[1] if back else pc.limits_y[0]}
        y["back"] = pc.limits_y[0] if back else pc.limits_y[1]
        return {
            f"{fb}_{lr}": (x[lr] + ox, y[fb] + oy)
            for fb in ("front", "back")
            for lr in ("left", "right")
        }

    def setup_goto(self, target: str) -> list[float]:
        """Show a position: the photo position, a corner of the limits, the plate centre."""
        self._idle()
        layout = self.layout()
        x0, y0, x1, y1 = layout.work_rect()
        spots = {
            **self._limit_corners(),
            "centre": ((x0 + x1) / 2, (y0 + y1) / 2),
        }
        with self._lock:
            self.motion.preflight(home=False)
            if target == "photo":
                self.motion.photo_position()
            elif target == "change":
                self.motion.change_position()
            elif target in spots:
                self.motion.travel(*spots[target])
                self.printer.gcode("M400")
            else:
                raise ValueError(f"unknown position {target!r}")
            return [round(v, 2) for v in self.motion.current_tip()]

    def setup_picker(self, action: str) -> dict[str, Any]:
        """Grab or release where the tool is (the Pi's pins): nothing moves."""
        self._idle()
        do = {"grab": self.pins.grab, "release": self.pins.release}.get(action)
        if do is None:
            raise ValueError("action must be grab or release")
        with self._lock:
            do()
        self._setup_picker.add(action)
        self.say(f"picker: {action}")
        return self.setup_state()

    def setup_rotate(self, angle: float | None = None) -> dict[str, Any]:
        """Tweezers: turn to `angle` (the jaws then close along it; the offset is added).
        Nothing else moves."""
        self._idle()
        pk = self.m.picker
        if not pk.kind.rotates:
            raise PrinterError(f"the {pk.kind.title.lower()} does not turn")
        a = float(angle or 0) % 180
        with self._lock:
            self.motion.turn(a + pk.rotate_offset_deg)
        self.say(f"tweezers turned to {a:.0f}°")
        self._setup_picker.add("rotate")
        return self.setup_state()

    def setup_confirm(self, key: str) -> dict[str, Any]:
        if key not in SETUP_KEYS:
            raise ValueError(f"unknown setup step {key!r}")
        if key == "homing" and not self._setup_homed:
            raise PrinterError("press Home now and watch where Z comes down first")
        if key == "machine" and not self.setup.is_done("printer"):
            raise PrinterError("check the printer first")
        if key in ("printer", "tip", "camera", "layout"):
            raise PrinterError("this step is checked by the machine, not by hand")
        if key == "picker":
            return self.setup_picker_ok()
        if key == "lights":
            st = self.lights.state()
            if st["enabled"] and not st["ok"]:
                raise PrinterError(f"the lights: {st['message']}")
            self.lights.apply()
            self.setup.mark("lights", "on" if st["enabled"] else "no lights")
            self.note("setup: lights " + ("confirmed" if st["enabled"] else ": none"))
            return self.setup_state()
        if key == "machine":  # the next step puts the picker on: the head goes where that is easy
            with self._lock:
                self.motion.preflight(home=False)
                self.motion.change_position()
            self.say("the head waits at the picker-change position: put the picker on")
        self.setup.mark(key)
        self.note(f"setup: {key} confirmed")
        return self.setup_state()

    def setup_picker_ok(self) -> dict[str, Any]:
        """The picker is on the head (Setup tab, Picker: OK): its pins work, and Klipper is told
        (TOOL_PICKER) so that sorting may move. Only a person can say it is on."""
        self._idle()
        ok, why = self.pins.status()
        if not ok:
            raise PrinterError(f"the picker's pins: {why}")
        if self.m.printer.tool_macro:
            self.setup_tool("picker")
        self.setup.mark("picker", self.m.picker.kind.title)
        self.note(f"setup: picker ({self.m.picker.kind.title.lower()}) is on")
        return self.setup_state()

    def setup_reset(self, key: str) -> dict[str, Any]:
        self.setup.reset(key)
        return self.setup_state()

    def _place_bins(self, layout: Layout, shot: Shot, T: Transform2D) -> list[dict[str, Any]]:
        """Move every bin whose marker is in the photo to where it is; unknown markers become new
        wild bins."""
        moved = []
        for marker, centre, yaw in self._seen_bins(layout, shot, T):
            known = layout.bin_by_marker(marker) is not None
            nb = layout.place_from_marker(marker, centre, yaw)
            moved.append({"marker": marker, "x": nb.x, "y": nb.y, "rot": nb.rot, "new": not known})
        return moved

    # ------------------------------------------------------------------ the start-up check
    def _startup_now(self) -> str:
        """Recheck (the page): the start-up check alone."""
        self._start_up()
        return "start-up check done: ready"

    def _start_up(self) -> None:
        """Homing, layout check (resync), bins check (what each bin holds), ready: startup.py.
        A step that fails stops the check (and the run) with the reason on the list."""
        sc = self.startup
        sc.begin()
        self.note("start-up check")
        self.say("start-up check: homing, layout, bins")
        try:
            sc.set("homing", "running")
            self.phase("start-up: homing")
            with self._lock:
                self.motion.preflight()
            sc.set("homing", "done", "homed")

            sc.set("layout", "running")
            self.phase("start-up: finding the bins")
            layout, T = self.layout(), self.transform()
            shot = self.take_shot(layout, T, area="bins", paint="bins")
            sc.set("layout", "done", self._startup_layout(layout, shot, T))

            sc.set("bins", "running")
            if getattr(self.vision, "model_missing", lambda: None)():
                sc.set("bins", "skipped", "no model: the bins keep what they had")
            else:
                self.phase("start-up: looking into the bins")
                sc.set("bins", "done", self._bins_check(layout, shot, T))
            sc.set("ready", "done", "ready to sort")
        except Exception as exc:
            sc.fail_running(str(exc))
            raise
        self._started_up = True
        self.say("start-up check done: ready")

    def _startup_layout(self, layout: Layout, shot: Shot, T: Transform2D) -> str:
        """Resync from the photo; the plate stays the one it was (run start never re-chooses
        it). Changes and saves `layout`."""
        seen = self._seen_bins(layout, shot, T)
        if not seen:
            raise PrinterError("the camera sees no bin codes (markers covered or dirty?)")
        old, old_auto = layout.work_marker, layout.work_auto
        report = layout.resync(seen)
        if old is not None and layout.work_marker != old and layout.bin_by_marker(old):
            layout.set_work(old, auto=old_auto)
        problems = layout.problems()
        if problems:
            raise PrinterError("layout: " + "; ".join(problems))
        layout.save(self.layout_path)
        wb = layout.work_bin()
        text = f"{len(report['found'])} bins, tray {layout.bin_name(wb) if wb else 'none'}"
        if report["removed"]:
            text += f"; not seen: {', '.join(map(str, report['removed']))}"
        self.note(f"start-up: {text}")
        return text

    def _bins_check(self, layout: Layout, shot: Shot, T: Transform2D | None) -> str:
        """What each bin holds (binscheck.py), from one model pass on the whole board: Resync
        and the start-up check only. Parts on a bin's code are not counted (the printed code
        looks like parts to the model), nor unknown or unsure ones. A wild bin with parts
        collects their kind, an empty one is free; one with only unknown parts keeps what it
        had. An empty bin with no rules becomes wild. A bin with rules keeps them (a kind its
        rules do not take is told). The picture with the result replaces the photo."""
        spots = binscheck.code_spots(shot, T)
        per_bin, dropped = binscheck.sort_out(layout, shot.parts, self.m.run.min_score, spots)
        looks: list[binscheck.BinLook] = []
        filled: list[str] = []
        empty: list[str] = []
        changed = False
        with self._claims_lock:
            for b in layout.bins:
                if b.role == "work":
                    continue
                mk, cell = b.marker, layout.bin_name(b)
                seen = per_bin.get(mk, [])
                ps = [p for p in seen if not p.unknown]
                look = binscheck.BinLook(mk, cell, seen)
                looks.append(look)
                if b.role == "sort" and not b.holds and not seen:
                    b.role, changed = "wild", True
                if b.role != "wild":
                    look.result = self._bins_check_kept(b, ps)
                    continue
                if seen and not ps:  # only unknown parts: maybe the code after all
                    look.result = f"unknown only: kept ({self.claims.get(mk) or 'free'})"
                    continue
                if ps:
                    key = kind_of(ps, layout.wild_by)
                    vol = sum(part_volume_mm3(p, self.m.run.fill, self.volumes) for p in ps)
                    if self.claims.get(mk) == key:  # the same kind: the camera sees only the top
                        n = max(len(ps), self.bin_counts.get(mk, 0))
                        vol = max(vol, self.bin_volume.get(mk, 0.0))
                    else:
                        n = len(ps)
                    if self.claims.get(mk) != key:
                        self.say(f"bin {cell} ({mk}): {key} seen in it, collects {key} now")
                    self.claims[mk], self.bin_counts[mk], self.bin_volume[mk] = key, n, vol
                    self.bin_family[mk] = family(Counter(p.cls for p in ps).most_common(1)[0][0])
                    filled.append(f"{cell} {key} ({n})")
                    look.result, look.changed = f"{key} ({n})", True
                else:
                    for d in (self.claims, self.bin_counts, self.bin_volume, self.bin_family):
                        d.pop(mk, None)
                    self.requests = [r for r in self.requests if r.marker != mk]
                    empty.append(cell)
                    look.result = "empty: wild, free"
            self._save_claims()
        if changed:
            layout.save(self.layout_path)
        text = f"{len(filled)} with parts" + (f": {', '.join(filled)}" if filled else "")
        text += f"; {len(empty)} empty, free wild bins" + (f": {', '.join(empty)}" if empty else "")
        if dropped:
            text += f"; {len(dropped)} on codes, not counted"
        self.note(f"bins check: {text}")
        self.say(f"bins check: {text}")
        self._show_bins_check(shot, T, layout, looks, dropped, spots)
        return text

    def _bins_check_kept(self, b: Any, ps: list[Part]) -> str:
        """A bin with its own role or rules keeps them: what is written on it."""
        if b.role != "sort":
            return b.role
        rules = ", ".join(b.holds)
        if ps and not any(rule_match(r, p) != "no" for r in b.holds for p in ps):
            seen = kind_of(ps, "part")
            self.say(f"bin {b.marker}: {seen} seen in it, but its rules take {rules}: kept")
            return f"rules {rules} (holds {seen}?)"
        return f"rules {rules}"
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
