ama24/sortering-pnp/src/sortering_pnp/printables/cups.py

"""Suction cups in TPU 95A for the suction picker: one straight body, five tips, the M and L
ones also with a sieve.

The body: a Ø7 shank that goes 7 mm into the picker's socket, held by 3 M3 screws at 120 deg
that press into blind holes (blind: a hole through to the bore would leak), then a straight Ø7
neck of 10 mm or more with the Ø4.3 bore of the pump's tube. No channel is wider than 4.3 mm:
the folds of the bellows go inwards (the passage narrows to Ø2.6 there, as wide as the tip's
hole). Every cup is 37 mm long, shank's end to lip.

`wide` (a second set, `_wide`): the same tips on a wider bellows, Ø9.5 outside with folds 1.6 mm
deep (the normal ones: Ø5.2, 0.85 mm), out from the neck and back in at 45 deg. The bellows is a
chamber, not a channel: inside it is Ø5.4 at its narrowest, the shank, the neck and every hole
stay as they are. Same walls, same length; softer: a fold's axial rate goes with
D x t^3 / depth^3, so twice the depth beats the bigger diameter (about 3.5 times softer along the
axis, 1.7 times sideways, as stiff to tilt). The vacuum pulls it shut on a sealed part
(about 2.6 N at -60 kPa on its 7.5 mm mean diameter): it lifts the part by its few mm of travel.

The folds and the cup are soft: the folds one line thick (0.45 mm), the cup's wall 0.6 mm
thinning to a one-line lip, the floor 0.6 mm (thicker ones, 0.9-1 mm, did not compress and felt
like PLA). The hole is big (Ø2.2-2.5): the screw's head lies on the lip and closes the cup, so
it only has to be smaller than the smallest head the tip picks (HEAD_COVER of it).
- A: three folds and a cone lip: flat faces (pan, button, cheese and hex heads, nuts).
- D: four folds and a skirt flaring to its one-line edge: takes up a few mm of height and
  follows curved or tilted faces.
S, M and L are the lip's size (S for M2-M3 heads, M for M4-M5, L for M6, M8 at a pinch).
`sieve` (M and L tips): instead of one hole, a dome with a ring of holes; the part rests on the
dome's flat top, 0.4 mm below the lip (the lip seals first), so the holes on its sides stay open:
the part can't plug the cup, more air flows, and it lets go at once. The S tips have no room for
one a 0.4 mm nozzle can print (their cup is Ø3 inside).

Printed standing on the shank's end, tip up, no supports: every overhang is 45 deg or steeper
(the dome and the floors are cones). TPU 95A, 0.4 mm nozzle, 3 walls, slow (20-25 mm/s).

Sized for a 0.4 mm nozzle (checked by slicing): every wall at least one line (MIN_LINE, measured
across each layer), every hole at least MIN_HOLE, and a web of two lines between two sieve holes:
thinner webs are dropped by the slicer and the holes merge.
"""

from __future__ import annotations

import math
from dataclasses import dataclass, field

from manifold3d import CrossSection, Manifold

from .meshio import Mesh

SEG = 72  # facets round the axis
NOZZLE = 0.4
MIN_LINE = 0.42  # one line of a 0.4 nozzle: no wall thinner (it would drop out)
SOFT_WALL = 0.6  # the folds and the cup: at most this (a line and a bit), so they give
MIN_HOLE = 1.2  # TPU closes smaller holes up
HEAD_COVER = 0.65  # a hole at most this part of the smallest head the tip picks: the head
# lies on the lip and closes the cup, so nothing goes in


@dataclass(frozen=True)
class Tip:
    name: str  # AS, AM, DS, DM, DL
    style: str  # "A" cone lip | "D" thin skirt
    lip_d: float  # outside Ø of the lip
    rim_t: float  # lip wall at the rim (D: the skirt's edge)
    depth: float  # floor (or the dome's top) to the rim
    folds: int  # bellows folds
    pitch: float  # mm per fold
    amp: float  # how far a fold goes in
    fold_t: float  # wall of the folds (measured across, horizontally)
    hole_d: float  # the single hole (without sieve)
    sieve_d: float  # each hole of the sieve (0: no sieve, no room for one)
    min_head_d: float  # the smallest head the tip picks (it covers the hole)
    use: str


TIPS: dict[str, Tip] = {
    t.name: t
    for t in (
        Tip(
            "AS", "A", 4.4, 0.45, 1.8, 3, 2.4, 0.85, 0.45, 2.2, 0.0, 3.8, "M2-M3 heads, flat faces"
        ),
        Tip(
            "AM", "A", 6.2, 0.45, 2.2, 3, 2.4, 0.85, 0.45, 2.5, 1.5, 7.0, "M4-M5 heads, flat faces"
        ),
        Tip(
            "DS", "D", 5.2, 0.45, 2.6, 4, 2.4, 0.85, 0.45, 2.2, 0.0, 3.8, "M2-M3, curved or tilted"
        ),
        Tip(
            "DM", "D", 7.6, 0.45, 3.2, 4, 2.4, 0.85, 0.45, 2.5, 1.5, 5.5, "M3-M5, curved or tilted"
        ),
        Tip("DL", "D", 10.6, 0.45, 3.8, 4, 2.4, 0.85, 0.45, 2.5, 1.5, 8.5, "M5-M6 (M8), curved"),
    )
}


@dataclass(frozen=True)
class Cup:
    tip: Tip
    sieve: bool = False
    body_d: float = 7.0  # shank and neck: straight
    shank_l: float = 7.0  # into the picker's 7 mm socket
    wide: bool = False  # the wide bellows (folds out from the neck), else folds inwards
    neck_l: float = 10.0  # below the socket, at least (longer to make every cup `length` long)
    wide_neck_l: float = 4.0  # the same with the wide bellows (it takes 6.6-7.5 mm more)
    length: float = 37.0  # shank's end to the lip, the same for every cup: swap, no recalibrating
    wide_d: float = 9.5  # the wide bellows' outside
    wide_amp: float = 1.6  # how far its folds go in (inside Ø5.4 at the narrowest)
    wide_pitch: float = 3.2  # mm per fold (2 x amp: 45 deg)
    bore_d: float = 4.3  # the pump tube's inside: no channel wider
    shank_bore_d: float = 3.2  # narrower in the shank: wall left behind the screws' holes
    fix_z: float = 3.5  # the M3 screws' axis, from the shank's end (the socket's bottom)
    fix_d: float = 2.6  # blind hole for an M3 screw's point (the thread bites around it)
    fix_depth: float = 1.0
    floor_t: float = 0.6  # the plate the hole goes through, the dome (3 layers)
    recess: float = 0.4  # the dome's top below the rim: the lip seals first
    plateau_r: float = 0.45  # the dome's top, where the part rests: no hole there
    web: float = 0.9  # TPU between two sieve holes (two lines: one was dropped by the slicer)
    holes: list[tuple[float, float]] = field(default_factory=list, compare=False)

    @property
    def name(self) -> str:
        return (
            f"cup_{self.tip.name}"
            + ("_sieve" if self.sieve else "")
            + ("_wide" if self.wide else "")
        )

    @property
    def min_neck(self) -> float:
        return self.wide_neck_l if self.wide else self.neck_l


def _inside(c: Cup) -> tuple[float, float, float]:
    """(the cup's inside radius at its floor, its wall there, at the rim)."""
    t = c.tip
    rim_in = t.lip_d / 2 - t.rim_t
    if t.style == "A":  # a short cup, its inside a little conical (straight with the sieve)
        ci, wall = (rim_in if c.sieve else rim_in - 0.4), SOFT_WALL
    else:  # the skirt: its inside flares 0.6 mm more, SOFT_WALL thick at the base
        ci, wall = rim_in - 0.6, SOFT_WALL
    return ci, wall, rim_in


def _profile(c: Cup) -> tuple[list[tuple[float, float]], dict[str, float]]:
    """The half section, its neck made longer so the lip is at `length` (the same for every cup:
    the tip height stays when the cup is swapped)."""
    _, marks = _profile_at(c, c.min_neck)
    extra = c.length - marks["rim"]
    if extra < -1e-9:
        raise ValueError(
            f"{c.name}: {marks['rim']:.2f} mm long with the shortest neck, over {c.length:g}"
        )
    return _profile_at(c, c.min_neck + extra)


def _profile_at(c: Cup, neck_l: float) -> tuple[list[tuple[float, float]], dict[str, float]]:
    """The half section (r, z) to revolve, from the shank's end (z = 0) up to the lip, and the
    heights that matter: the outside up, the inside back down, one simple polygon. Every slope
    is 45 deg or steeper: it prints standing on the shank with no supports."""
    t = c.tip
    R, rb, rs = c.body_d / 2, c.bore_d / 2, c.shank_bore_d / 2
    z_neck = c.shank_l + neck_l
    r_fold = rb + t.fold_t  # the folds' outside, before folding in
    inner = [(rs, 0.0), (rs, c.shank_l), (rb, c.shank_l + rb - rs)]
    if c.wide:  # out at 45 deg to the wide bellows, its folds, back in at 45 deg
        rw, amp, h = c.wide_d / 2, c.wide_amp, c.wide_pitch / 2
        z = z_neck + (R - r_fold)  # the bore widens from z_neck: the wall thins to one line
        outer = [(R, 0.0), (R, z), (rw, z + (rw - R))]
        z += rw - R
        inner += [(rb, z_neck), (rw - t.fold_t, z)]  # the inside: the outside less one line
        for _ in range(t.folds):
            outer += [(rw - amp, z + h), (rw, z + 2 * h)]
            inner += [(rw - t.fold_t - amp, z + h), (rw - t.fold_t, z + 2 * h)]
            z += 2 * h
        z += rw - r_fold  # back in to the normal folds' top
        outer.append((r_fold, z))
        inner.append((rb, z))
    else:
        outer = [(R, 0.0), (R, z_neck), (r_fold, z_neck + (R - r_fold))]
        z = z_neck + (R - r_fold)
        inner.append((rb, z))
        for _ in range(t.folds):  # each fold in, then out: 45 deg at most (amp <= pitch / 2)
            h = t.pitch / 2
            outer += [(r_fold - t.amp, z + h), (r_fold, z + 2 * h)]
            inner += [(rb - t.amp, z + h), (rb, z + 2 * h)]
            z += 2 * h
    z_b = z
    ci, wall, rim_in = _inside(c)
    marks = {"neck_top": z_neck, "folds_top": z_b}
    if c.sieve:  # out to the cup's inside, then a dome (45 deg) up to its flat top
        q = z_b + abs(ci - rb)
        under = q + (ci - c.plateau_r)
        top = under + c.floor_t
        floor = q + c.floor_t  # where the dome meets the wall
        rim = top + c.recess
        inner += [(ci, q), (c.plateau_r, under), (0.0, under), (0.0, top), (c.plateau_r, top)]
        marks |= {"dome_under": under, "dome_top": top}
    else:  # in to the hole (a cone), through the plate, a funnel out to the cup's wall
        r0 = t.hole_d / 2
        p2 = z_b + (rb - r0)
        p3 = p2 + c.floor_t
        floor = p3 + (ci - r0)
        rim = floor + t.depth
        inner += [(r0, p2), (r0, p3)]
        marks |= {"hole_top": p3}
    inner.append((ci, floor))
    base_r = ci + wall
    if c.sieve:
        rise = abs(base_r - r_fold)  # out (or in) to the cup at 45 deg, along the floor below it
        z1 = max(z_b, floor - rise)
        if base_r > r_fold:  # the cone under the dome flares out from the folds' top: follow
            z1 = z_b  # it at once, or the wall between them thins to nothing
        if z1 > z_b + 1e-9:
            outer.append((r_fold, z1))
        outer.append((base_r, z1 + rise))
        if floor > z1 + rise + 1e-9:
            outer.append((base_r, floor))
    else:  # a thin floor, no wedge: in at 45 deg along the cone to the hole, a short ring
        r_min = t.hole_d / 2 + wall  # round the hole, out at 45 deg along the funnel
        outer += [(r_min, z_b + (r_fold - r_min)), (r_min, marks["hole_top"]), (base_r, floor)]
    n = 1 if t.style == "A" else 8
    for k in range(1, n + 1):  # A: one straight cone; D: a skirt flaring and thinning
        u = k / n
        zz = floor + (rim - floor) * u
        ro = base_r + (t.lip_d / 2 - base_r) * (u if t.style == "A" else u**1.6)
        th = wall + (t.rim_t - wall) * u
        outer.append((ro, zz))
        inner.append((ro - th, zz))
    marks |= {"floor": floor, "rim": rim}
    return outer + list(reversed(inner)), marks


def holes(c: Cup) -> list[tuple[float, float]]:
    """(x, y) of the sieve's holes: rings on the dome's sides, none on its top (the part rests
    there, so it can't cover them), from the outside in, a `web` apart straight across. At
    least 3."""
    d = c.tip.sieve_d
    if d <= 0:
        raise ValueError(f"{c.tip.name}: no sieve (no room for one)")
    ci = _inside(c)[0]
    lo = c.plateau_r + d / 2 + c.web / 3  # a third of a web to the plateau's edge and to the
    hi = ci - d / 2 - c.web / 3  # cup's wall: the dome's slope and the wall add to it
    step = d + c.web
    out: list[tuple[float, float]] = []
    rho, k = hi, 0
    while rho >= lo - 1e-9:
        n = int(math.pi / math.asin(min(1.0, step / (2 * rho))))
        if n < 3:
            break
        for j in range(n):
            a = 2 * math.pi * j / n + (k % 2) * math.pi / n
            out.append((rho * math.cos(a), rho * math.sin(a)))
        rho -= step
        k += 1
    if len(out) < 3:
        raise ValueError(f"{c.tip.name}: no room for a sieve of Ø{d:g} holes")
    return out


def walls(c: Cup, dz: float = 0.05) -> list[tuple[float, float, float]]:
    """(z, r_in, r_out) of every solid run of the section, layer by layer: how wide the slicer
    sees each wall (the sieve's and the screws' holes not counted)."""
    poly, marks = _profile(c)
    edges = list(zip(poly, poly[1:] + poly[:1], strict=True))
    out = []
    z = dz / 2
    while z < marks["rim"]:
        xs = sorted(
            r0 + (r1 - r0) * (z - z0) / (z1 - z0)
            for (r0, z0), (r1, z1) in edges
            if (z0 <= z < z1) or (z1 <= z < z0)
        )
        out += [(z, a, b) for a, b in zip(xs[::2], xs[1::2], strict=True)]
        z += dz
    return out


def build(c: Cup) -> Manifold:
    poly, marks = _profile(c)
    body = CrossSection([poly]).revolve(SEG)
    # the three M3 screws: blind holes into the shank, 120 deg apart
    R = c.body_d / 2
    for k in range(3):
        a = 90.0 + 120.0 * k
        pin = (
            Manifold.cylinder(c.fix_depth + 1.0, c.fix_d / 2, c.fix_d / 2, 24)
            .rotate([0, 90, 0])
            .translate([R - c.fix_depth, 0, c.fix_z])
            .rotate([0, 0, a])
        )
        body = body - pin
    if c.sieve:  # vertical holes through the dome
        under, top, pl = marks["dome_under"], marks["dome_top"], c.plateau_r
        for x, y in holes(c):
            rho = math.hypot(x, y)
            z0 = under + min(0.0, pl - rho) - 0.2  # the dome's underside there (45 deg)
            z1 = top + min(0.0, pl - rho) + 0.2
            h = Manifold.cylinder(z1 - z0, c.tip.sieve_d / 2, c.tip.sieve_d / 2, 16)
            body = body - h.translate([x, y, z0])
    return body


def cup_mesh(c: Cup) -> Mesh:
    from .gridfinity import _to_mesh

    return _to_mesh(build(c))


def all_cups() -> list[Cup]:
    """The normal set, then the wide one: every tip, with a sieve where there is room."""
    return [
        Cup(t, s, wide=w)
        for w in (False, True)
        for t in TIPS.values()
        for s in (False, True)
        if t.sieve_d > 0 or not s
    ]


CUP_NOTES = """Suction cups for the suction picker (sortering-pnp print catalogue: prints/cups/)

Material: TPU 95A. 0.4 mm nozzle, 0.2 mm layers, 3 walls (or more: the folds are walls only),
100 % infill, 20-25 mm/s, no supports. Stand it on the shank's end (as exported), tip up.
The folds and the lip are one line of a 0.4 nozzle (they must give), the cup's wall {soft:g} mm,
every hole at least Ø{min_hole:g}: checked by slicing every cup (Bambu Studio, classic and Arachne
walls). Slow down for the folds (15-20 mm/s) if the slicer allows.

Fit: the Ø7 shank goes 7 mm into the picker's socket; 3 M3 screws, 120 deg apart, {fix_z:g} mm from
the socket's bottom, press into its blind holes (Ø{fix_d:g}, {fix_depth:g} mm deep: they don't reach
the bore, nothing leaks). Snug them, don't crush the TPU.

Length: every cup, normal or wide, is {length:g} mm from the shank's end to the lip (the neck
makes up the difference, {neck:g} mm or more below the socket, {wide_neck:g} mm or more with the
wide bellows): swap cups without measuring the tip height again.

Body: straight Ø7, bore Ø4.3 (the pump's tube; Ø3.2 in the shank,
behind the screws). The normal set's folds go inwards: no channel is wider than 4.3 mm.

Wide set (_wide): the same tips and holes on a wider bellows, Ø{wide_d:g} outside, folds
{wide_amp:g} mm deep every {wide_pitch:g} mm (the normal ones Ø5.2, 0.85 mm every 2.4 mm), out from the
neck and back in at 45 deg, the same one-line walls. The bellows is a chamber, not a channel:
inside it is Ø{wide_in:g} at its narrowest (wider than the tube); the shank, the neck and the holes are
the same. About 3.5 times softer along the axis (a fold's rate goes with diameter x wall^3 /
depth^3: the deeper folds win over the bigger diameter), 1.7 times softer sideways, as stiff
to tilt. On a sealed part the vacuum pulls it shut (about 2.6 N at -60 kPa, against 0.7 N on
the normal bellows): it lifts the part by a few mm and holds it on its closed folds.

Tips (each hole smaller than the smallest head the tip picks: the head lies on the lip and
closes the cup, nothing goes in):
{table}
A: three folds and a cone lip, for flat faces (pan, button, cheese and hex heads, nuts).
D: four folds and a skirt flaring to a one-line edge: a few mm of give, follows curved and
   tilted faces (the side of a head, countersunk heads).
_sieve (AM, DM, DL): a dome with a ring of holes instead of one. The part rests on the dome's
   flat top, 0.4 mm below the lip, so the holes on its sides stay open: it can't plug the cup,
   more air flows, and it lets go at once. Holding force is the same (vacuum x the lip's area).
   AS and DS have none: a 0.4 nozzle can't print one in their Ø3 cup (and on AS the head rests
   on the lip, well above the hole).
"""


def cup_files() -> list[tuple[str, bytes]]:
    from .meshio import stl_bytes

    out = []
    rows = []
    for c in all_cups():
        out.append((f"{c.name}.stl", stl_bytes(cup_mesh(c), c.name)))
        if not c.sieve:
            t = c.tip
            sv = f"sieve: {len(holes(Cup(t, True)))} x Ø{t.sieve_d:g}" if t.sieve_d else "no sieve"
            _, marks = _profile(c)
            bellows = f"Ø{c.wide_d:g} bellows" if c.wide else "Ø5.2 bellows"
            rows.append(
                f"  {c.name[4:]:8s} lip Ø{t.lip_d:g}, {t.folds} folds, {bellows}, hole "
                f"Ø{t.hole_d:g} ({sv}), neck {marks['neck_top'] - c.shank_l:.1f} mm: {t.use}"
            )
    c0 = Cup(TIPS["AS"])
    notes = CUP_NOTES.format(
        fix_z=c0.fix_z,
        fix_d=c0.fix_d,
        fix_depth=c0.fix_depth,
        neck=c0.neck_l,
        wide_neck=c0.wide_neck_l,
        wide_d=c0.wide_d,
        wide_amp=c0.wide_amp,
        wide_pitch=c0.wide_pitch,
        wide_in=round(c0.wide_d - 2 * (c0.wide_amp + c0.tip.fold_t), 2),
        length=c0.length,
        min_hole=MIN_HOLE,
        soft=SOFT_WALL,
        table="\n".join(rows),
    )
    out.append(("CUPS.txt", notes.encode()))
    return out
