ama24/sortering-pnp/(commit log)

2026-11-07 Keep sorting: share a bin with the same class, use bins seen mid-run
    - run.share_wild (class by default): a new length with no free wild bin goes in
    with its class (DIN912_M2x5 into the DIN912_M2x8 bin) before a bin change is asked.
    - Waiting for a bin, and after a bin change, the bins are photographed again: a bin
    left out at the run's start (code covered), put back or new is used from then on,
    and bin changes asked for new kinds are asked again only if still needed.
    [machine.yaml]
2026-11-07 Start-up check (homing, layout, bins, ready) and a countdown in automatic mode
    - startup.py: the first run after sortering-pnp starts homes, resyncs from one bins
    photo and runs the model once on that whole (unpainted) picture: a wild bin with
    parts collects their kind, an empty one is free; nothing on or next to a code is
    counted. run.startup_check; Device tab card with a tick per step and Check again.
    - A wild bin claimed for a class takes every length of it.
    - Automatic mode: "next look in 45 s", counted down on the page (next_look_s).
    [machine.yaml]
2026-11-07 Ring light: sandwich the board between bracket and clamp, thinner diffuser
    - Measured board: 40 mm OD, 19.9 mm ID.
    - The bracket is flat underneath with a spigot in the board's hole that centres it;
    the clamp ring and the diffuser take the board and its tab in a recess 0.15 mm
    shallower than the board, so the M2 screws press it flat. No pocket in the bracket.
    - Diffuser window 1.0 -> 0.6 mm; bracket 2.6 mm. Still M2 x 10 (M2 x 12 with the diffuser).
    [ring_bracket.stl, ring_clamp.stl, ring_diffuser.stl]
2026-11-07 Addressable LEDs on the Pi's SPI, and a Lights step in Setup
    - leds.py: WS2812B (e.g. the LumenPnP ring) on SPI0 MOSI, GPIO10 / pin 19, written to
    /dev/spidev0.0 with the standard library (3 SPI bits per LED bit at 2.4 MHz); SimLeds
    for the simulator. Lit always, or only while a photo is taken.
    - config `lights:` (enabled, count, colour, brightness, always_on, settle_s, order, SPI);
    the page's choice kept in machine.json.
    - Setup: a Lights step before the camera: colour picker, hex, R/G/B and intensity
    sliders shown live on the LEDs, Always on, Off, OK; No lights completes it.
    - install-pi.sh: dtparam=spi=on, core_freq_min=500, the spi group.
    - docs (Hardware: Lights, wiring), CLAUDE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
    [machine.yaml]
2026-11-07 Camera Calibration tab: rotate 90 / mirror, camera adjustments, shorter wording
    - Rotate 90 (clockwise) and Mirror: the camera's flips plus a quarter turn in
    software (camera.turn90) for photos, the live picture and rpicam-still; the nominal
    camera turns with it. Redo Camera to printer afterwards, as before.
    - Focus (auto / manual lens position / Autofocus once), white balance (auto / manual
    gains), exposure (auto / manual shutter and gain), brightness, contrast, sharpness,
    saturation: camera.adjust, kept in machine.json, applied at once over the automatic
    or locked settings (camera.controls_for); the simulator accepts them.
    - Removed the leftover Tip height / Camera to printer car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
    [machine.yaml]
2026-11-07 Device: start-up list in the menu, buttons that act at once, every photo shown
    - Start-up check under Device in the left menu (ticks, Recheck); off the Device body.
    - Recheck, Resync and Change bin take over: the run or automatic mode stops after
    the move in progress, the action runs, automatic mode carries on (Runner._take_over).
    Recheck failed before while automatic mode ran ("already running: stop first").
    - Change bin while automatic mode stands by now parks and checks (was ignored);
    swap_phase "parking" until it really is parked.
    - Every photo on the page as soon as it is taken (Vision.preview, before the model),
    with the bins' codes and cells drawn on it; the camera note counts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
    [runner.py, test_binswap.py, test_device.py, test_device_control.py, vision.py]
2026-11-07 Ring light: M3 screws instead of M2
    4 x M3 x 12 (M3 x 16 with the diffuser): 3.4 mm clearance holes in the clamp,
    diffuser and bracket, 2.5 mm pilots 10 mm deep in thicker legs (r 3.4), the four
    screws 24.4 x 41 mm apart so the legs stay clear of the bar screws' screwdriver.
    [camera_arm_ring.stl, ring_bracket.stl, ring_clamp.stl, ring_diffuser.stl]
2026-11-07 Camera arm: the Camera Module 3 clears the ring bracket and its cable a slot
    From the official drawing (RP-008153-DS-1): the lens housing is 10.8 mm square
    (15.3 mm corner to corner, 3.875 mm out of the board) and did not fit the bracket's
    15 mm hole: the hole is now 16.4 mm. Board 1.12 mm, lens 8.1 mm from the board's
    back, lens 14.4 mm from the edge by the holes; the cable's connector is on the far
    edge, so the cable leaves towards the front: on the ring arm it goes straight up
    through a 3 mm slot in the pod, between the front legs. The view-cone test now allows
    0.5 mm on the lens length (it comes from the drawing).
    [camera_arm.stl, camera_arm_ring.stl, ring_bracket.stl]
2026-11-07 Camera arm: 135 mm from the bar to the lens (was 148)
    The default reach (and the CLI, web page and API defaults) is now 135 mm, measured
    on the printer: the arm's back, flat on the bar, to the camera's centre.
    [camera_arm.stl, camera_arm_ring.stl]
2026-11-07 install-pi.sh: SPI lines under [all], SPI on at once, clearer reboot note
    config.txt may end in a filtered section ([cm4], [pi4], ...): a line appended there is ignored
    on other boards, so /dev/spidev0.0 never appeared. The lines now go under [all]; SPI is also
    switched on at once with dtparam; the reboot note names the LEDs.
    [leds.py]
2026-11-07 Lights step: a wiring diagram for the LED ring; the Pi header names its power pins
    The ring's 5 V comes from a buck converter on the printer's 24 V supply (not the Pi's 5 V
    pins); DIN on pin 19 (GPIO10), GND on pin 20, all GND joined. Drawn like the picker's wiring,
    with the pins, parts and notes below it. Both diagrams share one Pi header (piHeader) on which
    5V, 3V3 and GND are coloured and named as a guide only: just the outlined pins are wired.
2026-11-07 Rotate: turning the quarter turn off again reloads the nominal camera too
    Rotate twice (0 -> 90 -> 180) left the expected picture size taller (2592x4608) while the
    photos were wide again (4608x2592): Take photo and Find bins failed with "neither the full
    frame nor the ROI" until a restart. The setup is now reloaded whenever the quarter turn changes.
    [runner.py, test_camera_adjust.py]
2026-11-07 Camera to printer: Move tip here, back to a recorded point
    A button left of Tip is here, on each code with a recorded point: the tip goes to that point's
    X/Y at the travel height, then 2 mm above the code (as Check does), to see whether the point
    was taken on the code's centre. POST /api/calib/goto_point {"marker"}.
2026-11-08 Device tab: shows what really runs; bin changes on one line above the bed
    The Automatic button was always drawn as the primary (filled) button, and the page's "automatic"
    came from the remembered mode, not from what runs: after a restart that did not start it (Setup
    unfinished) the machine stood idle while the page looked automatic. The runner now reports
    mode (auto, sort, step, task or "") from its running thread; the header shows a state chip
    (Automatic · waiting · next photo in 0:42, Sort once · sorting, Idle) and only the buttons that
    apply (Start automatic, Look now, Pause, Resume, Stop). Sort once and One pick moved under a small
    Manual menu. Nothing is highlighted before it is pres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
2026-11-08 X/Y acceleration profile: a limit per axis, on by default
    printer.y_motion (bed only) becomes printer.xy_motion: accel_x 3000 (the head, the Ender 3's
    own) and accel_y 1000 (the bed, loose parts on it). Every move that changes X or Y gets the
    largest acceleration whose X and Y parts stay within their limits, min(ax/|ux|, ay/|uy|), with
    the S-curve speed profile, set back after the move and never above the printer's own. While the
    picker holds a part both limits are x carrying (0.6). An old y_motion section is read as
    xy_motion (accel/max_feed -> accel_y/max_feed_y).
    [machine.yaml]
2026-11-08 Bins check by the model on the whole board (Resync, start-up); code labels on the codes
    Resync and the start-up check's Bins check run the model once on the whole calibrated photo
    (nothing painted, the trained scale kept) and give every detection to the bin whose floor holds
    it (binscheck.py). Detections on a bin's code are dropped: where the layout puts the code and
    where the photo shows it (a code on a rim appears shifted outwards on the floor plane). A wild
    bin with parts collects their kind, an empty one is free, one with only unknown parts keeps
    what it had; a bin with rules keeps them and the console says what was seen. The photo is shown
    at once, then the result drawn on it: each bin'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
2026-11-08 Carrying a part lowers only the head's (X) acceleration
    The part hangs on the picker, which X moves; the bed (Y) carries the tray whether a part is held
    or not, so its limit stays.
    [machine.yaml]
2026-11-08 Every start is a new session: an empty grid (bed.cols x bed.rows, 5 x 5), no bins
    On a real printer `serve` starts with Runner.fresh_session(): the layout keeps its settings but
    no bins, on the grid from the new `bed:` section of machine.yaml (5 x 5 by default, for a
    bigger machine set it there); claims, counts and open bin changes are cleared, the learnt
    packing stays. Resync or the start-up check finds the bins again. The simulator keeps its
    layout (its camera sees the layout file).
    [machine.yaml]
2026-11-08 The bed ramps like a mill: 200 mm/s^2, 50 mm/s, no corners at speed, gentle homing
    Screws still slid on the plate when Y moved:
    - accel_y 1000 -> 200 mm/s^2, max_feed_y 3000 mm/min, 12 S-curve steps: up to 50 mm/s in
    0.375 s over 9.4 mm.
    - Klipper took the corner between a Z move and a Y move at its square corner velocity (5 mm/s):
    a jump in the bed's speed with no ramp. Bed moves are now sent with SQUARE_CORNER_VELOCITY=0
    and Klipper's value (read from the toolhead) is set back after.
    - Homing (and the homing macro's G1 to the middle) ran at the printer's full acceleration: it
    now runs at accel_y with no corners at speed.
    - standby.motors_off now false by default: with it on, automa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
    [machine.yaml]
2026-11-08 Straight ramps by default; the installer sets up Klipper's config itself
    - printer.xy_motion.profile: trapezoid by default. One G1 per move: Klipper's own ramp, the
    speed rises in a straight line. The s_curve steps came out as stairs (Klipper reaches each
    step's speed quickly, then holds it); kept as an option.
    - `sortering-pnp klipper` (klippercfg.py), run by install-pi.sh: copies sortering_pnp.cfg
    (an edited copy kept as .bak), puts its include in printer.cfg once, after the user's sections
    and before SAVE_CONFIG's block, comments out [safe_z_home], removes the old picker include,
    warns about KIAUH's placeholder, a missing/wrong [mcu] serial, a second [save_variables], no
    [disp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
    [machine.yaml, sortering_pnp.cfg]
2026-11-08 Suction cups in TPU 95A: one straight body, five tips, with and without a sieve
    printables/cups.py, in the catalogue (prints/cups/): a Ø7 shank 7 mm into the picker's socket
    with 3 blind holes for M3 screws at 120 deg (Ø3.2 bore there, so they don't reach it), a straight
    Ø7 neck of 20 mm with the pump tube's Ø4.3 bore, bellows that fold inwards (no channel over
    4.3 mm). Tips AS, AM (two stiff folds, short lip: flat faces) and DS, DM, DL (four soft folds,
    a skirt thinning to 0.45 mm: curved faces), each also _sieve: a dome with 4-14 holes on its
    sides, its top (where the part rests) 0.4 mm below the lip. Every hole under an M2's core.
    Revolved profiles, every slope 45 deg or steeper: prin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
    [cup_AM.stl, cup_AM_sieve.stl, cup_AS.stl, cup_AS_sieve.stl, cup_DL.stl, cup_DL_sieve.stl, cup_DM.stl, cup_DM_sieve.stl]
2026-11-08 Suction cups: every one 47 mm long, shank to lip
    The neck makes up the difference (20 mm or more), so swapping cups keeps the tip height.
    [cup_AM.stl, cup_AM_sieve.stl, cup_AS.stl, cup_AS_sieve.stl, cup_DL.stl, cup_DL_sieve.stl, cup_DM.stl, cup_DM_sieve.stl]
2026-11-08 Suction cups sized for a 0.4 mm nozzle, checked by slicing
    Sliced in Bambu Studio (0.4 nozzle, TPU 95A, classic and Arachne walls):
    DL sieve did not slice at all (the wall between the cone under the dome
    and the outside thinned to 0.1 mm: empty layers, the cup above floated),
    DM sieve went down to 0.3 mm there, and the sieves' 0.45 mm webs were
    dropped so their Ø0.7-0.9 holes merged.
    - The outside follows the cone under the dome from the folds' top.
    - Every wall at least two lines across each layer (MIN_WALL 0.85), the D
    skirt's edge one line; floor 0.9, plateau Ø0.9, A lips 0.85.
    - Holes at least Ø1.2 (MIN_HOLE), webs 0.9 measured hole to hole: sieves
    of 3 / 5 / 9 holes on AM / DM /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
    [cup_AM.stl, cup_AM_sieve.stl, cup_AS.stl, cup_AS_sieve.stl, cup_DL.stl, cup_DL_sieve.stl, cup_DM.stl, cup_DM_sieve.stl]
2026-11-08 Servos: wait for udev to hand a new PWM channel to the gpio group
    Choosing the pneumatic tweezers exported pwm1 (the turning servo) for the
    first time, and writing its period failed at once: "Permission denied:
    /sys/class/pwm/pwmchip0/pwm1/period". The channel's files exist as soon as
    it is exported but stay root's until udev gives them to the gpio group a
    moment later; the code only waited for them to exist.
    - Every sysfs write tries again on PermissionError for up to 3 s, then
    says what to do (install-pi.sh, gpio group, reboot).
    - install-pi.sh adds /etc/udev/rules.d/99-sortering-pnp-pwm.rules: the
    gpio group gets every PWM chip and every channel exported on it,
    whatever path the ke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
    [pins.py, test_pickers.py]
2026-11-08 Tool holder: an L bracket for the tweezers' turning stepper
    The printer plate takes the printer's interface (2 x M3, 14 mm apart);
    the motor plate sticks out at 90 deg from its foot. The motor (NEMA 8
    size, 20 x 20 x 30 mm, M2.5 on a 16 mm square, Ø15 flange) stands inside
    the L, its flange down through the plate, 4 x M2.5 from below. The M3
    screws sit above the motor's top with a hex key's room over it; a rib
    each side of the motor carries the bend. 26 x 27 x 46 mm, 4 mm plates,
    about 9 g; prints standing on the motor plate, no supports (teardrop M3
    holes). Every size is a ToolHolder field. In the catalogue: prints/tool/.
    [tool_holder.stl]
2026-11-08 Soft suction cups: one-line folds and lip, a thin floor, bigger holes
    The printed cups were too stiff: the folds (0.9-1.0 mm across) did not
    compress and the cup (0.9-1.0 mm walls, a solid wedge round the hole)
    felt like PLA.
    - Folds one line of a 0.4 nozzle (0.45 mm), 0.85 mm deep at 2.4 mm
    pitch; the A tips get three folds instead of two.
    - The cup's wall 0.6 mm (SOFT_WALL) thinning to a one-line lip on every
    tip; floor 0.6 mm.
    - The floor round the hole is a thin cone (in along the folds, a short
    ring round the hole, out along the funnel) instead of a solid wedge.
    - Holes Ø2.2 (S) and Ø2.5 (M, L): the screw's head lies on the lip and
    closes the cup, so a hole only has to be sma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
    [cup_AM.stl, cup_AM_sieve.stl, cup_AS.stl, cup_DL.stl, cup_DL_sieve.stl, cup_DM.stl, cup_DM_sieve.stl, cup_DS.stl]
2026-11-08 Park for photos at travel_z: no extra Z rise after every drop
    The fixed camera only needs the head out of the picture in X/Y, but
    photo_position() also went to photo_position's Z (60) after every drop,
    10 mm above travel_z (50), and the next pick came down those 10 mm again.
    New printer.photo_at_travel_z (default true) keeps travel_z there; the
    head camera still uses photo_position's Z (it sets the scale). The drop
    no longer sends a Z move to where the tip already is.
    [machine.yaml]
2026-11-08 Device tab: In the tray keeps the last analysis while the next photo is taken
    The photo preview cleared state.parts, which the page also used for the
    In the tray graph, so it showed "The tray is empty" during every photo.
    The runner now keeps a census of the last finished analysis (not changed
    by the preview, nor by a photo without a model) and an analysing flag;
    the page draws the graph from the census, never empties it on a missing
    field, and says "taking a new photo" meanwhile.
    [runner.py, test_device.py]
2026-11-08 Drawing: points for OpenCV are plain 32-bit ints (drawing.pt/poly)
    OpenCV 5 refuses a point unless both coordinates are plain ints that fit
    in 32 bits ("Can't parse 'center'. Sequence item with index 0 has a wrong
    type"). The calls already used int(), so what got through was a keypoint
    thrown far off the picture (a huge but finite value) in the measurement
    picture after each photo with a model (measure/infer.draw), which made the
    whole photo fail. drawing.pt rounds and clamps every point drawn,
    drawing.poly does the same for polygons, and non-finite keypoints and
    board corners are not drawn. Used by the measurement picture, the
    calibration overlay, the bins check picture and the tray mask.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
    [binscheck.py, calibjob.py, drawing.py, test_drawing.py, trayview.py]
2026-11-08 Suction cups 10 mm shorter, and a wide set with a Ø9.5 bellows
    Every cup is now 37 mm from the shank's end to the lip (was 47), the
    neck at least 10 mm (11.2 mm on DL, 18.2 on AS).
    Cup.wide: the same five tips and their sieves on a wider bellows, Ø9.5
    outside with folds 1.6 mm deep every 3.2 mm (the normal ones Ø5.2,
    0.85 mm every 2.4 mm), out from the neck and back in at 45 deg, the same
    one-line walls and length. A fold's axial rate goes with D t^3 / w^3: the
    deeper folds make it about 3.5 times softer along the axis, 1.7 times
    sideways; as stiff to tilt. Its inside is a chamber (Ø5.4 at the
    narrowest), wider than the tube; shank, neck and holes unchanged.
    Files cup_*_wide.stl, all li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
    [cup_AM.stl, cup_AM_sieve.stl, cup_AM_sieve_wide.stl, cup_AM_wide.stl, cup_AS.stl, cup_AS_wide.stl, cup_DL.stl, cup_DL_sieve.stl]
2026-11-08 Tool holder: M2 x 5 motor screws, standoffs and lever shims
    - The motor's screws are M2 and only M2 x 5 are at hand: Ø2.4 holes with
    counterbores from below, 2.5 mm of plate under the heads (heads flush in
    a 4.5 mm motor plate), so 2.5 mm of thread reaches into the motor.
    - The printer plate sits on the head's two 4.5 mm standoffs. It now goes
    up to 7 mm above the screws (the head's face ends 7.4 mm above them),
    and two 4.5 mm shims on its back rest on the head: one at the top
    between the standoffs, one 14.6 mm below the screws (the face goes 15 mm
    down). A push on the tool turns the plate about a shim and the screws
    hold it back, instead of everything hanging on the standoffs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
    [tool_holder.stl]
2026-11-08 Washers: a cup or a magnet takes them on the ring, not on the hole
    A washer's centre is its hole: the cup sucked air there and the magnet
    touched nothing. With aim "head" (suction, magnet) a washer class
    (DIN125, DIN127, DIN433, DIN6340, DIN9021, ISO7089/7090/7092/7093) is now
    taken on the middle of its ring: between the standard clearance hole of
    its thread size (WASHER_HOLE, e.g. M4 -> 4.3) and the outside (the
    outline's equivalent circle), on the side away from its nearest
    neighbour. Tweezers and every other part keep their grip. A ring
    narrower than 0.6 mm falls back to the centre.
    [grip.py, parts.py, test_grip_washers.py, vision.py]
2026-11-08 Camera: keep gain, exposure and focus inside what the sensor can do
    The Pi said "settings drifted during capture: AnalogueGain: locked 1.0,
    camera reports 1.1228070259094238". With manual exposure on the page the
    gain defaults to 1.0 (the slider's minimum), but the Camera Module 3's
    sensor (IMX708) has no gain under 1.1228: it ran at that, and the check
    that the camera really runs with the asked settings failed every photo.
    within_limits() clamps AnalogueGain, ExposureTime and LensPosition to the
    ranges Picamera2 reports (camera_controls) before they are sent, and the
    settings the frames are checked against are clamped the same way. A
    clamp is logged.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
    [camera.py, test_camera_adjust.py]
2026-11-09 README: new screenshots, what's new, install as it is today
    - Every screenshot taken again from the simulator (they still showed the old
    screwpick page): Device, bin menu, Setup, Picker, Camera Calibration,
    Print bins, Files, Real photos, On the machine; new ones for the Lights
    step, the Models tab, the suction cups and the tool holder.
    - Install: what install-pi.sh does step by step (PWM + udev rule, SPI and
    the LED clock, pinned packages, Klipper's config, the service), reboot
    once, sortering-pnp check; a table for pin and camera errors.
    - Setup has eight steps (Lights); the lights and their wiring; washers on
    the ring; start-up check and the empty grid at every start; Device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
    [machine.yaml]
2026-11-09 Setup: Fit's answer shows under the Fit button
    The fit result (or the reason it was refused) was written below the photo, the codes table
    and the jog pad, so after Fit nothing seemed to happen. The fit line now sits right under the
    buttons, a refusal scrolls into view, and a refused fit no longer leaves the last fit's line
    showing.
    [runner.py, test_setup.py]
2026-11-09 Drop parts where the camera saw the bin, not at its grid cell
    Bins were snapped to the 42 mm Gridfinity grid and parts dropped at the cells' centre. Bins
    standing loose on the bed (any place, any turn) are off that grid by up to half a cell, 21 mm,
    so parts fell beside small bins. Each bin now keeps its centre as measured from its code's
    place and direction (Bin.seen), and the drop goes there (Layout.drop_centre). A measurement more
    than half a cell from the bin's cells (moved on the page) or none (old layouts): the cells.
    [layout.py, runner.py, test_resync.py]
2026-11-09 Printables: a PLA tip that carries an earphone's silicone ear tip
    The cups' Ø7 shank and M3 blind holes (shallower: the bore is Ø4.2 all the way), and at the end
    a barb for the ear tip: a groove Ø5.5, 2 mm long, between the body's shoulder and a Ø7.5 collar
    with a 45 deg lead-in. In the catalogue as prints/cups/tip_eartip_pla.stl with EARTIP.txt.
    [tip_eartip_pla.stl]
2026-11-10 README: every command in its own block, not inside a sentence
    Install: the firmware build and flash, finding the printer's port, the Klipper console checks,
    sortering-pnp check, the log, sortering-pnp klipper and the page's address. Updating: the
    program-only restart. The tables point to those blocks.
2026-11-10 README: Install as plain steps and commands
    Seven numbered steps, each one short line and its commands. What the install script and the
    Klipper step do (the table and the list) moved to docs/reference.md, Installing.
2026-11-10 Tip height: an empty grid counts from the tray, like sorting does
    The Tip step ran with no bins known (every session starts empty, and Find
    bins comes later), so the touched floor was taken as Z 1.75. Sorting then
    aimed at the tray's 7.75, and the tip stayed 6 mm too high on every pick.
    surface_z() is now the tray's surface on an empty grid too; only a layout
    that has bins and no plate bin keeps the sheet on the bed. tool.json records
    the surface used, and the pick line shows the target Z and the assumed top.
    [layout.py, runner.py, test_auto.py, test_geometry.py]
2026-11-10 Suction cup: down over the part to the Tip step's height, whatever its size
    The cup used to stop on the part's top, so it never reached the height set
    in the Tip step. The slow descent still starts above the part's top.
    picker.cup_above_mm raises the stop; magnet and jaws are unchanged.
    [machine.yaml]
2026-11-10 Photos: wait for the bed to stop shaking, and never use a frame from before
    M400 ends when the moves do, but the bed still shakes for a moment, and the
    camera's stream hands over a frame it exposed earlier. A settle after every
    real move to the photo position (printer.photo_settle_s) and one discarded
    frame make the photo start after the bed has stopped.
    [machine.yaml]
2026-11-10 Drop: a bin at the bed's edge comes inside the limits instead of failing
    The middle of a shelf bin's opening can lie just past the soft limits when
    the bin faces the edge (Y222.77 of 220 on bin A5). Up to half a shelf's depth
    it is brought inside, still over the opening; further out it is refused.
    [runner.py, test_auto.py]
2026-11-10 Setup, Machine: the four corners on a schematic, each with Move tip here
2026-11-10 Setup, Machine: the X and Y limits are typed on the schematic's corners
    Corners that share a limit stay in step. Move tip here refuses unsaved limits.
2026-11-10 Setup, Machine: a Z scale beside the bed, Photo / Parked and Tool Change rows
2026-11-10 Setup: home corner on the bed drawing, Go to X/Y centre, an X/Y jog cross
    [machine.yaml]
2026-11-10 Setup, Lights: ON / OFF and photos only at the top; the LEDs follow the bars
2026-11-10 Setup, Lights: OFF ticks the step off, no separate "OK, no lights" button
2026-11-10 Setup, Lights: the LED status only when something is wrong
2026-11-10 Page: problems stand out in red; Camera to printer's message under its buttons
2026-11-13 Pump on the printer board's bed or hotend output
    picker.pump_switch: mosfet (a module on the Pi's pin, as before), bed or
    hotend. On the board's output the pump replaces that heater and Klipper
    switches it with SET_HEATER_TEMPERATURE (pump_heater_target to grab, 0 to let
    go). verify_heater stays on; the pump is refused while the heater reads over
    max_hotend_c; off() only sends 0 after an on(). Chosen in the Setup tab's
    Picker step, kept in machine.json.
    [machine.yaml]
2026-11-13 Pump on the printer board's part-cooling fan output
    picker.pump_switch: fan. The pump goes on the [fan] connector in place of the
    fan; FanPump sends M106 S255 to grab and M107 to let go (only after its own
    M106, so a print's fan is never stopped). No heater check, so no time limit.
    Refused when Klipper has no [fan]. PrinterStatus.fan_speed from Moonraker.
    [machine.yaml]
2026-11-13 Bins: a bins view for the model, and take-out only for well-filled bins
    Bins view (trayview.py): looking into the bins (start-up check, Resync, after
    a bin change) the codes are read first and each bin's floor is worked out from
    its code alone (size from the number, place and turn from the code); only those
    floors go to the model, walls, gaps and codes painted over, same picture size.
    camera.bins_mask (on) and camera.bins_margin_mm; Calibrate tab: Bins view, live
    beside the camera, edge setting, Snippets (each floor cut out, with its code).
    Take-out: a bin is flagged ready when its kind is done, or given up for a new
    kind, only when at least run.fill.take_out_at (0.5) full; otherwise the ne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
    [machine.yaml]
2026-11-13 Camera lock: exposure, white balance and focus from the centre of the picture
    The camera's own AE and AWB look at the whole picture, so a white bin made the
    photos too bright and tinted. After AE/AWB settle (spot metering), the lock now
    sets the exposure and the colour gains again from the centre 40 %
    (camera.centre_balance): the tray grey on average at a middle brightness, but
    never so bright that the brightest 0.5 % of the whole picture (a white bin)
    clips. Steps in linear light, repeated until steady (2-4). The continuous
    autofocus before the lock and Focus now use an AF window on the centre too.
2026-11-13 Calibrate tab: Lock again, alone (the lens and position stay)
2026-11-13 Speed: a live speed slider, faster empty Z, and a turbo mode
    - Z with nothing held (down to a part, up after a drop) at printer.feed_z_empty
    (900 mm/min), with a part at printer.feed_z (600). Klipper caps Z at its
    max_z_velocity: read at run start and said in the console;
    klipper/sortering_pnp.cfg shows how to raise it (commented out).
    - Device tab: Speed (50-300 %, run.speed_pct) scales every feed rate and
    acceleration the program sends, from the next move; kept in machine.json.
    - Device tab: Mode, Single (a photo per pick) or Turbo N (run.turbo_picks):
    N picks from one photo, then a photo analysed in a background thread while it
    keeps picking from the list; the results replace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
    [machine.yaml, sortering_pnp.cfg]
2026-11-13 Speed changes top speeds only, never the ramps; Klipper's Z at 15 mm/s
    - The Speed slider (run.speed_pct) scaled the accelerations too: at 200-300 %
    the moves started and stopped hard enough to roll loose screws. It now scales
    only the feed rates (and the axes' top speeds); accel_x/accel_y stay as tuned.
    - klipper/sortering_pnp.cfg: [printer] max_z_velocity 15, max_z_accel 200
    (was commented out): Klipper capped Z at an Ender 3's 5 mm/s, so faster Z
    feeds had no effect. Also applies while printing.
    [machine.yaml, sortering_pnp.cfg]
